OpenSourceSDRLab/RFSoC-27DR/images/RFSoC-27DR-angle-2.jpg

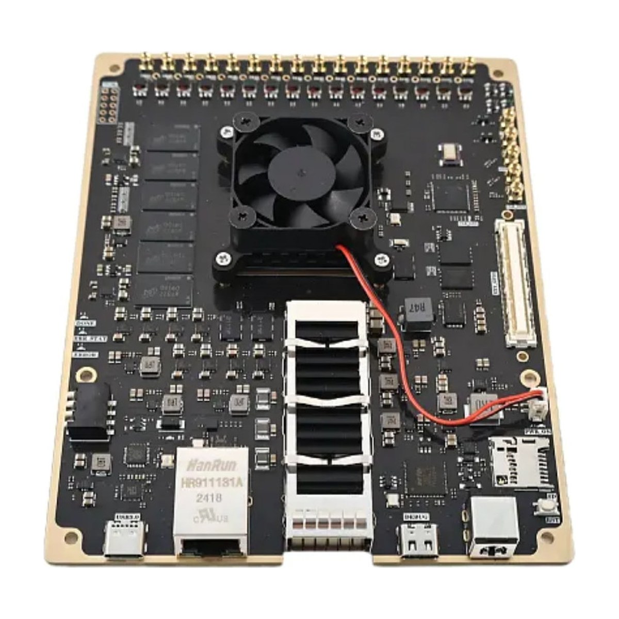
images/RFSoC-27DR-angle-2.jpg
