OpenSourceSDRLab/RFSoC-27DR/images/RFSoC-27DR-angle-3.jpg

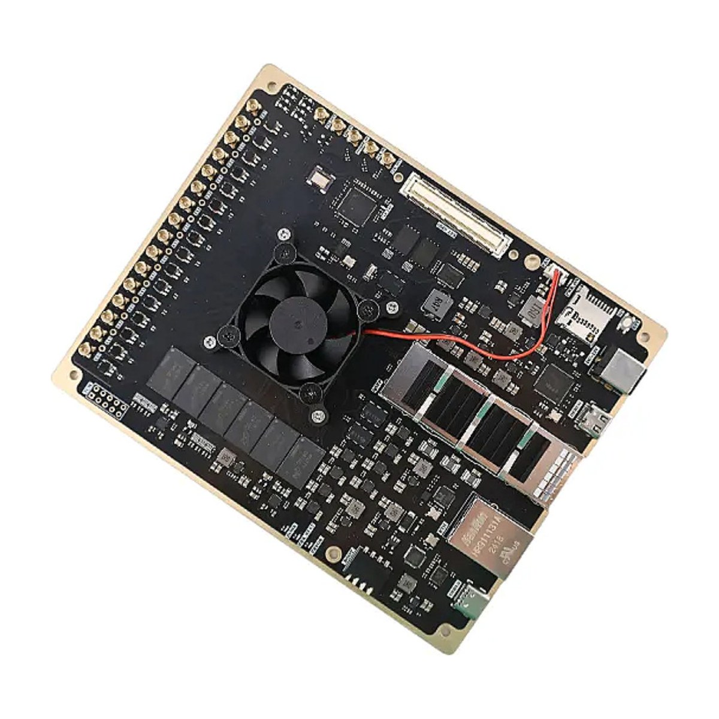
images/RFSoC-27DR-angle-3.jpg
