OpenSourceSDRLab/RFSoC-27DR/hardware/RFSoC-27DR_Schematic.pdf

## © 2026 OpenSourceSDRLab. All rights reserved. · www.opensourcesdrlab.com

# OPENSOURCESDRLAB DOCUMENTATION

# RFSoC-27DR Schematic

Product | RFSoC-27DR
Document | OSSDRLAB-RFSoC-27DR-SCH
Version | 1.0
Date | 2026-11-12

# This document contains the main schematic sheets of the OpenSourceSDRLab RFSoC-27DR board

(XCZU27DR RFSoC, 8T8R), exported from Altium Designer. It is a partial schematic: the power-supply (PMU) sheet is not included, and sheets 10 and 18 are blank in this edition. Some sheets carry short Chinese labels for function blocks; their meaning is given in the table. The schematic sheets follow this cover page.

OpenSourceSDRLab | RFSoC-27DR Schematic

## © 2026 OpenSourceSDRLab. All rights reserved. · www.opensourcesdrlab.com

Sheet | Content
1 | RFSoC PS configuration: system monitor, JTAG, boot mode, PS reference clock (33.3 MHz), PS MIO assignment (QSPI, SD, USB, Ethernet, UART, I2C, LMK04828 control)
2 | RFSoC PL I/O banks 88 and 89: LMK04828 SYNC, LEDs, PL clocks and SYSREF, expansion-connector I/O
3 | RFSoC I/O bank supply connections (VCCO)
4 | PS DDR4: four MT40A256M16GE devices, 64-bit
5 | PL DDR4: two MT40A256M16GE devices, 32-bit, banks 65/66
6 | PS-GTR transceivers (bank 505) and reference clocks
7 | GTY transceivers (quads 128 and 129) and reference clocks
8 | RF-ADC tiles 224–227 and RF-DAC tiles 228–229 with TC1-1-13MX+ baluns, converter reference clocks and SYSREF
9 | 12 V DC input and reverse-polarity protection (label: "DC power input")
10 | blank (power supply sheet not included)
11 | USB JTAG and UART: FT2232H, Type-C connector, EEPROM
12 | Gigabit Ethernet: RTL8211F PHY and RJ45
13 | USB 3.0: USB3320C ULPI PHY, Type-C connector and switch, VBUS power switch
14 | QSFP28 cage on GTY quad 128
15 | Clocking: LMK04828 clock generator, 19.2 MHz VCTCXO, 100 MHz and 156.25 MHz oscillators
16 | Other peripherals: reset supervisor ("reset control"), boot-mode switch ("boot mode": JTAG/QSPI/eMMC/SD), dual QSPI flash, I2C EEPROM, microSD slot ("TF card"), status and user LEDs ("indicator LEDs"), fan header ("fan")
17 | Expansion interface: FX10A-120S-SV 120-pin connector and MMCX clock / SYSREF / trigger connectors
18 | blank

Product page: https://opensourcesdrlab.com/products/opensourcesdrlab-rfsoc-development-board-equipped-with-usb-30-socket (https://opensourcesdrlab.com/products/opensourcesdrlab-rfsoc-development-board-equipped-with-usb-30-socket)

# Questions about the hardware: support@opensourcesdrlab.com

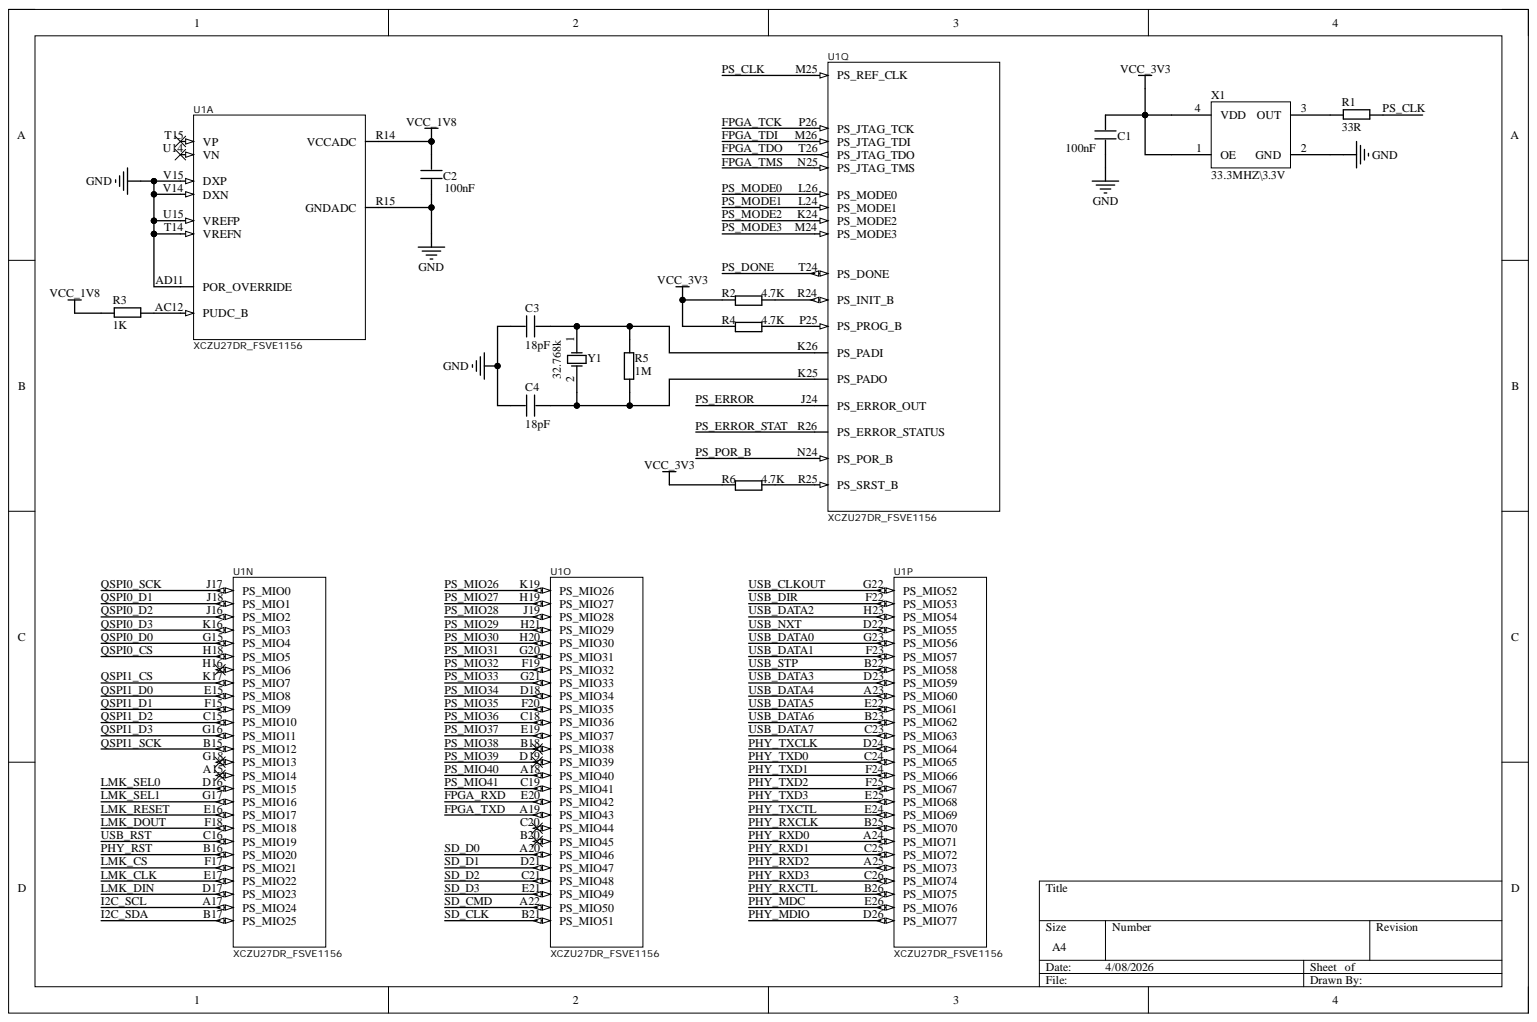
[picture p8: page 3]

### COU1D

### COU1E

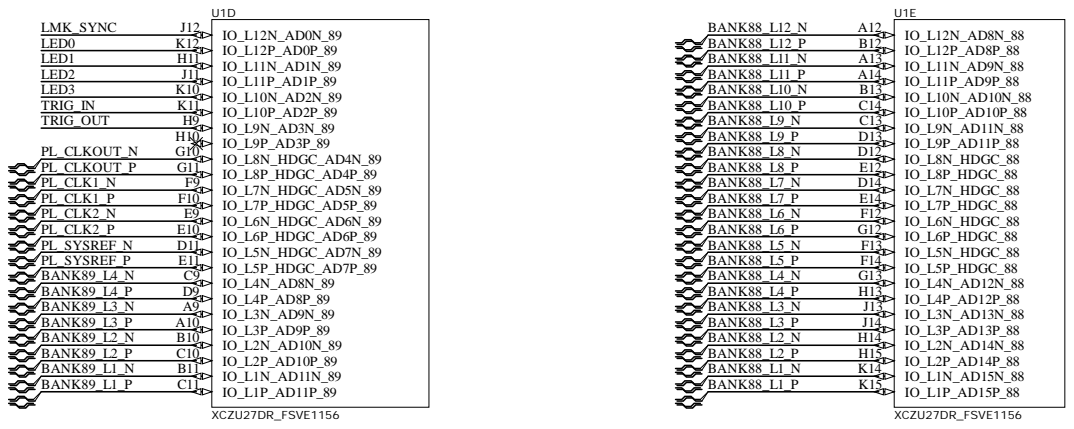
[picture p9: page 4]

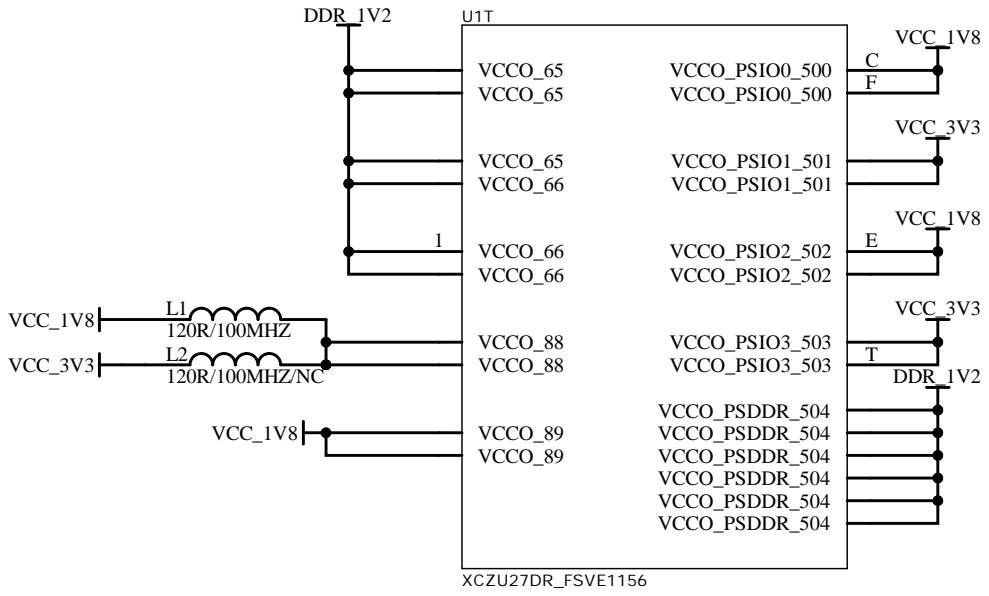
[picture p10: page 5]
VCC_3V3; VCC_1V8; 120R/100MHZ/NC; 120R/100MHZ; DDR_1V2; XCZU27DR_FSVE1156; VCCO_PSDDR_504; T VCCO_PSIO3_503; VCCO_PSIO3_503; VCCO_PSIO2_502; E VCCO_PSIO2_502; VCCO_PSIO1_501; F VCCO_PSIO0_500; C VCCO_PSIO0_500; VCCO_89; VCCO_88; VCCO_66; VCCO_65; File:; Date:; Sheet of; Size; Number; Revision; Title; PIL101; PIL102 COL1; PIL201; PIL202 COL2; PIU10AE12; PIU10AF15; PIU10AF25; PIU10AG28; PIU10AH11; PIU10AJ14; PIU10AK17; PIU10AK27; PIU10AL10; PIU10AL30 PIU10AN26; PIU10AP29; PIU10C17; PIU10D10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

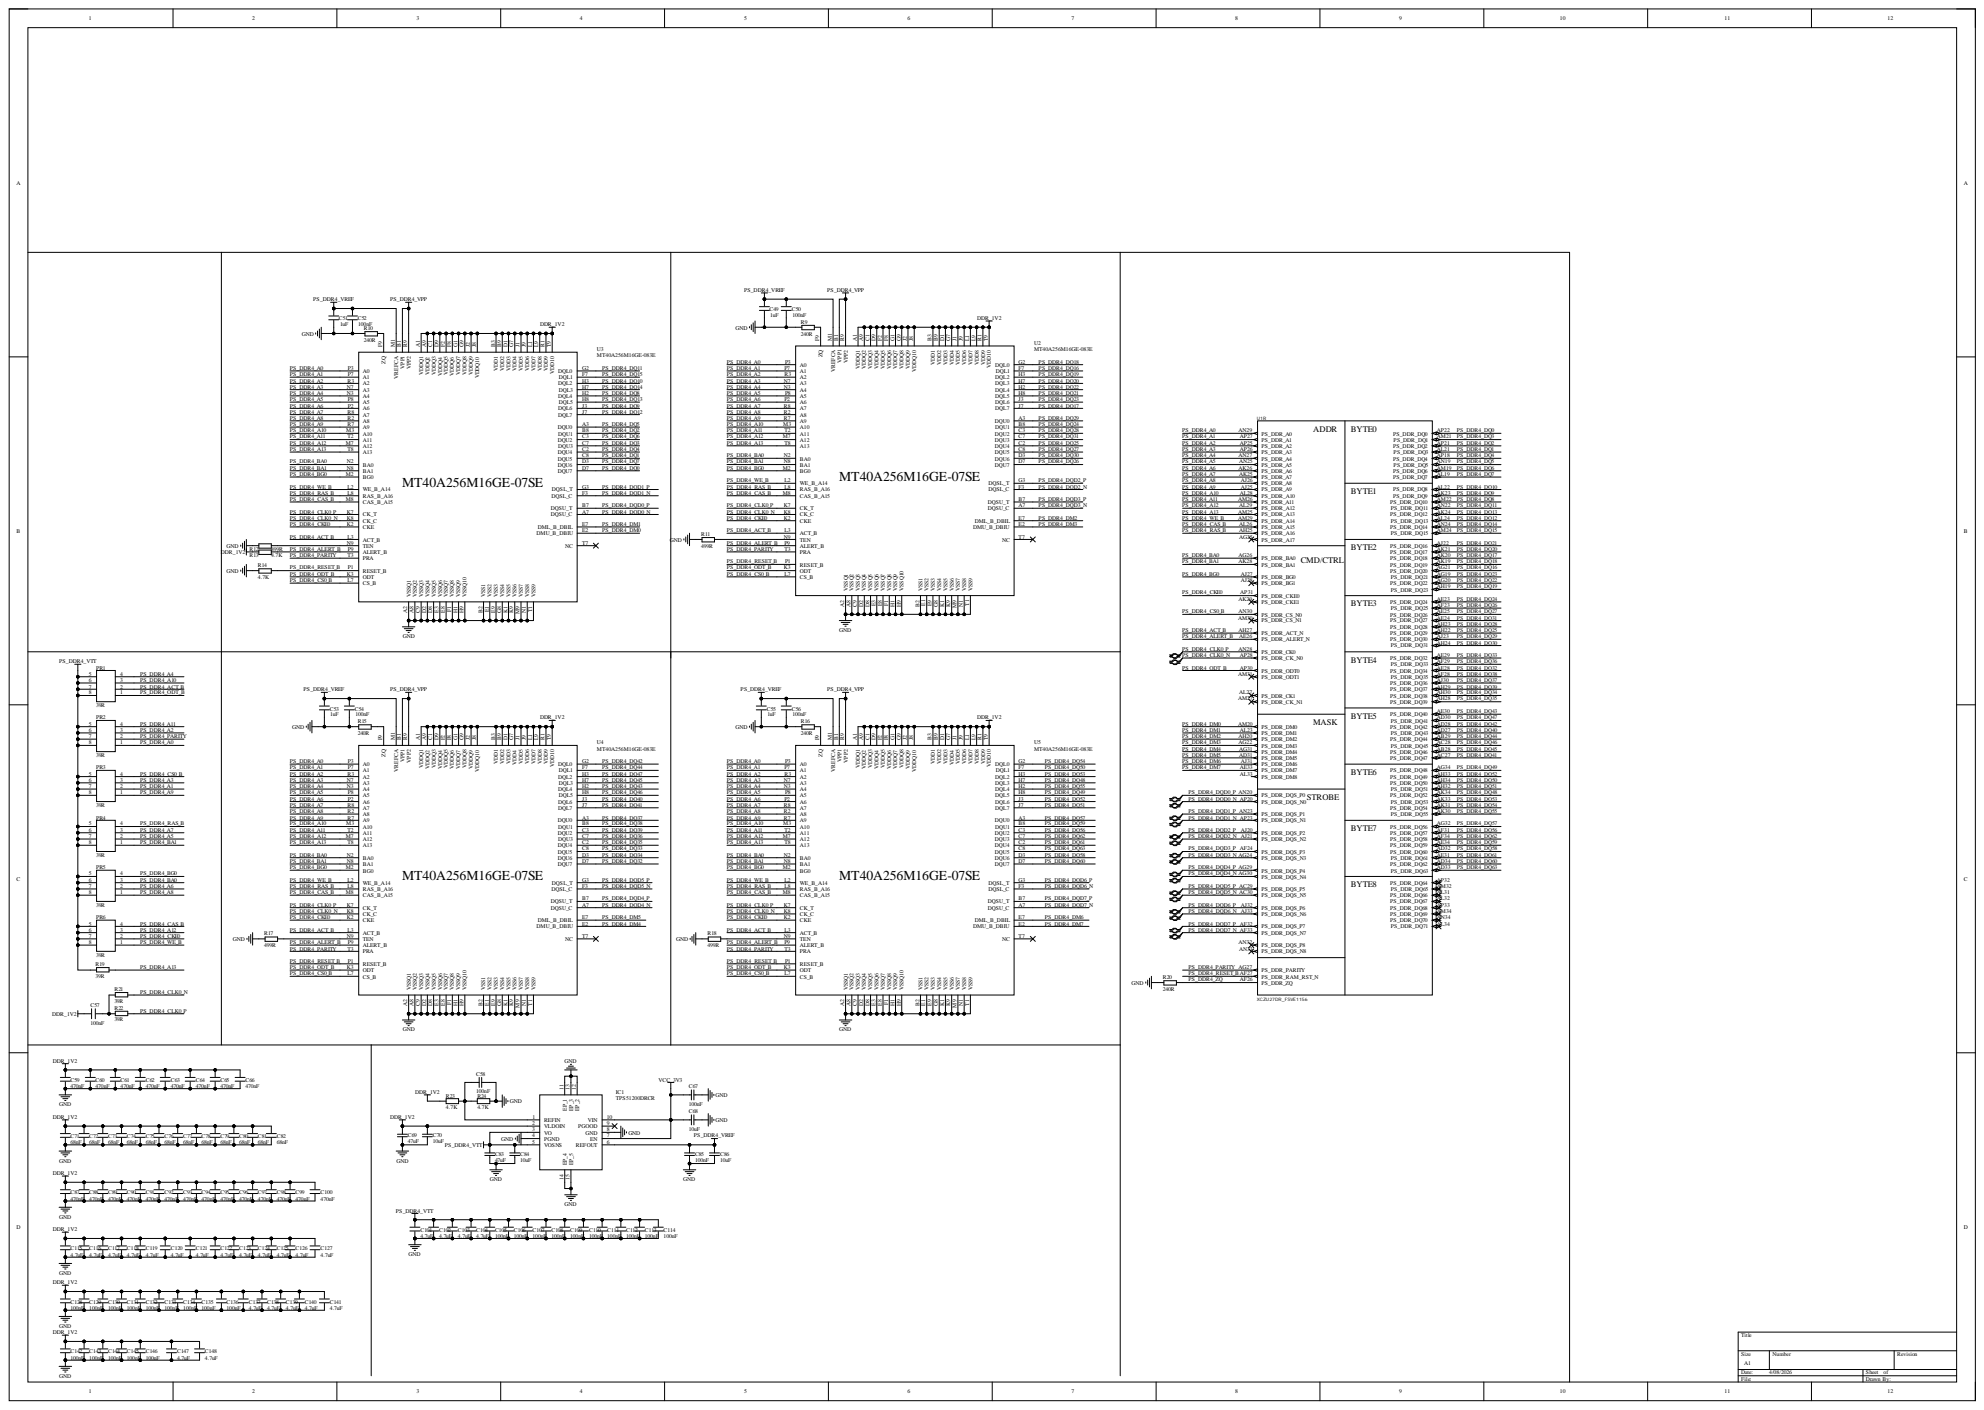
[picture p11: page 6]

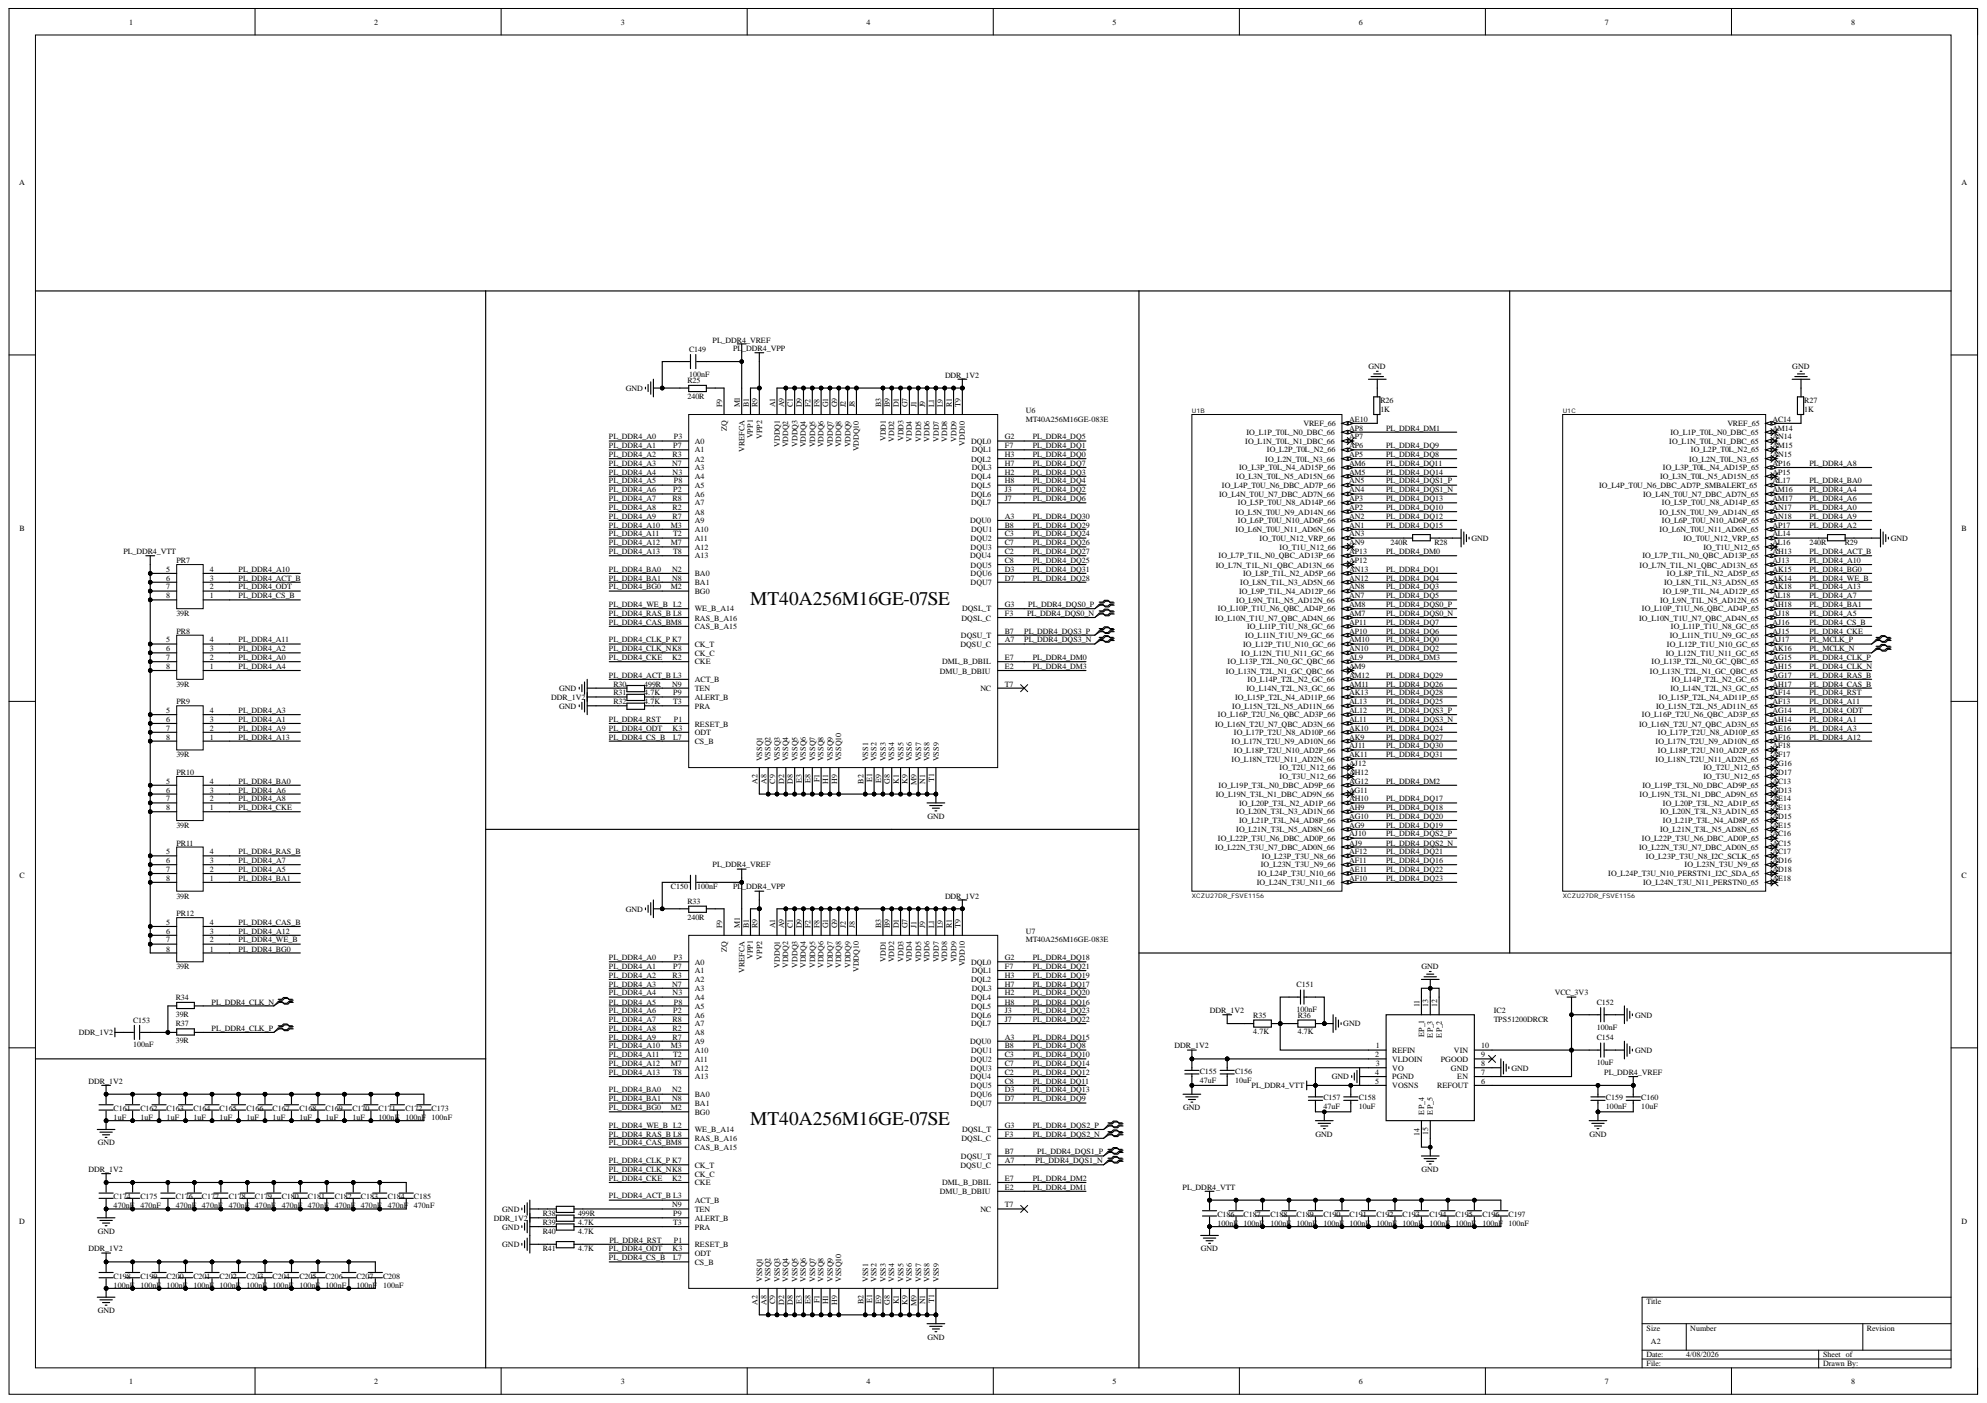
[picture p12: page 7]

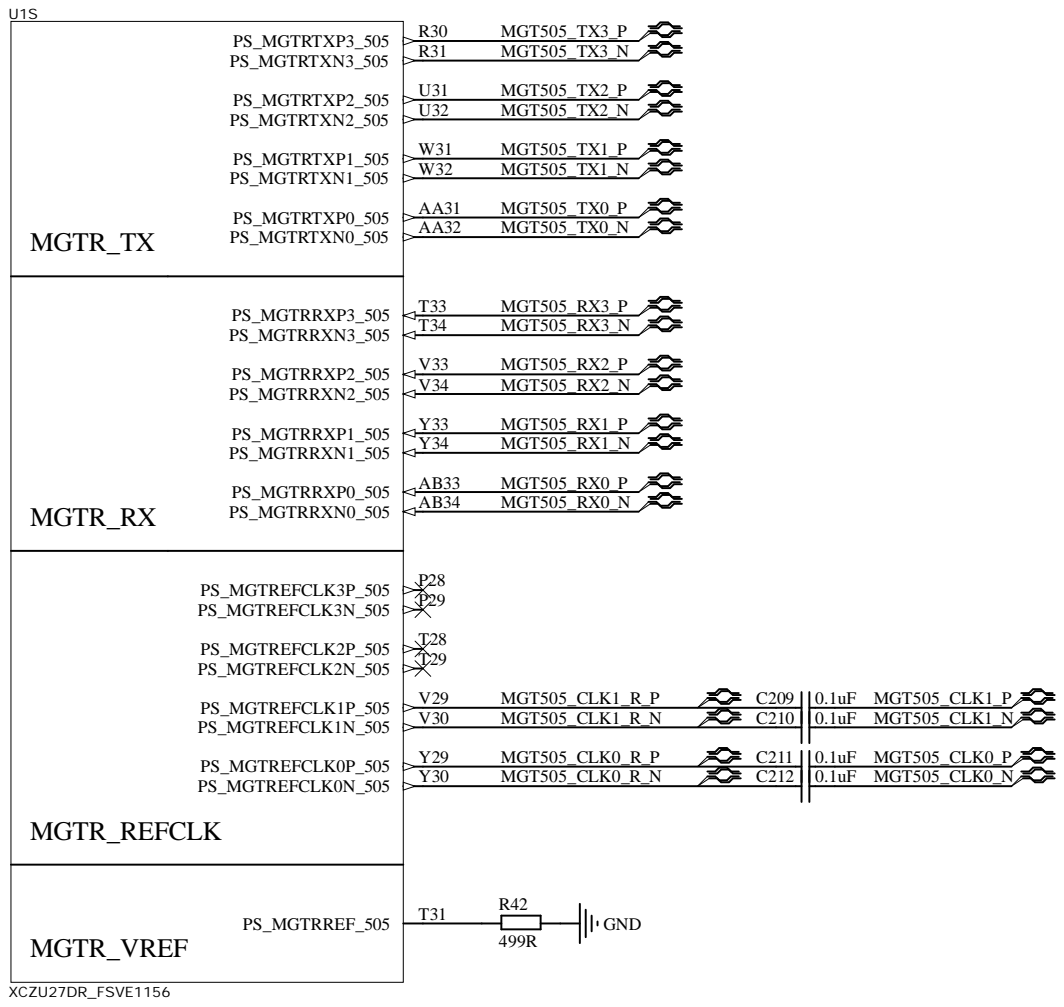
[picture p13: page 8]

M

## GTY_

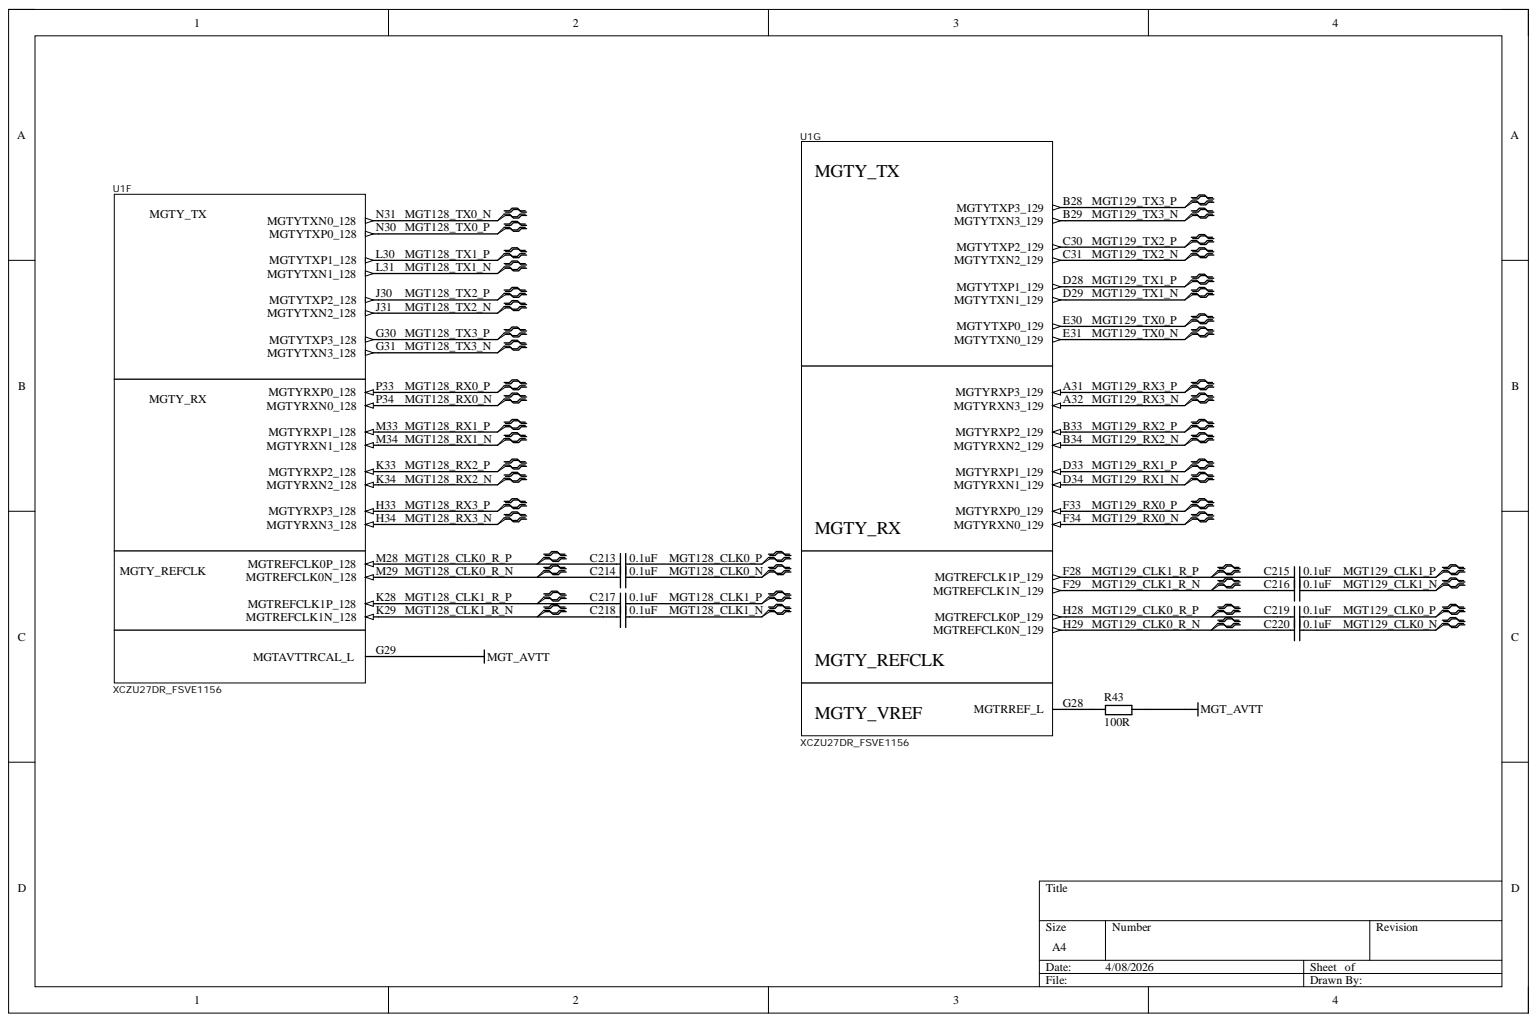
[picture p14: page 9]
Size; umb; Rev; Dat; Sheet; TREFCL; 9 MGTREFCLK0P_129; 9 MGTREFCLK1P_129; TRREF_; YRX; YRXP0; YRXP1; YRXP2; YRXP3; GTY_; GTY_REFC; GTY_VR; XCZU27DR_FSVE1156; 9 MGTREFCLK0P_128; 9 MGTREFCLK1P_128; TAV; TRCA; _REFCL; Drawn By:

# U1I XCZU27D

# U1H XCZU27D

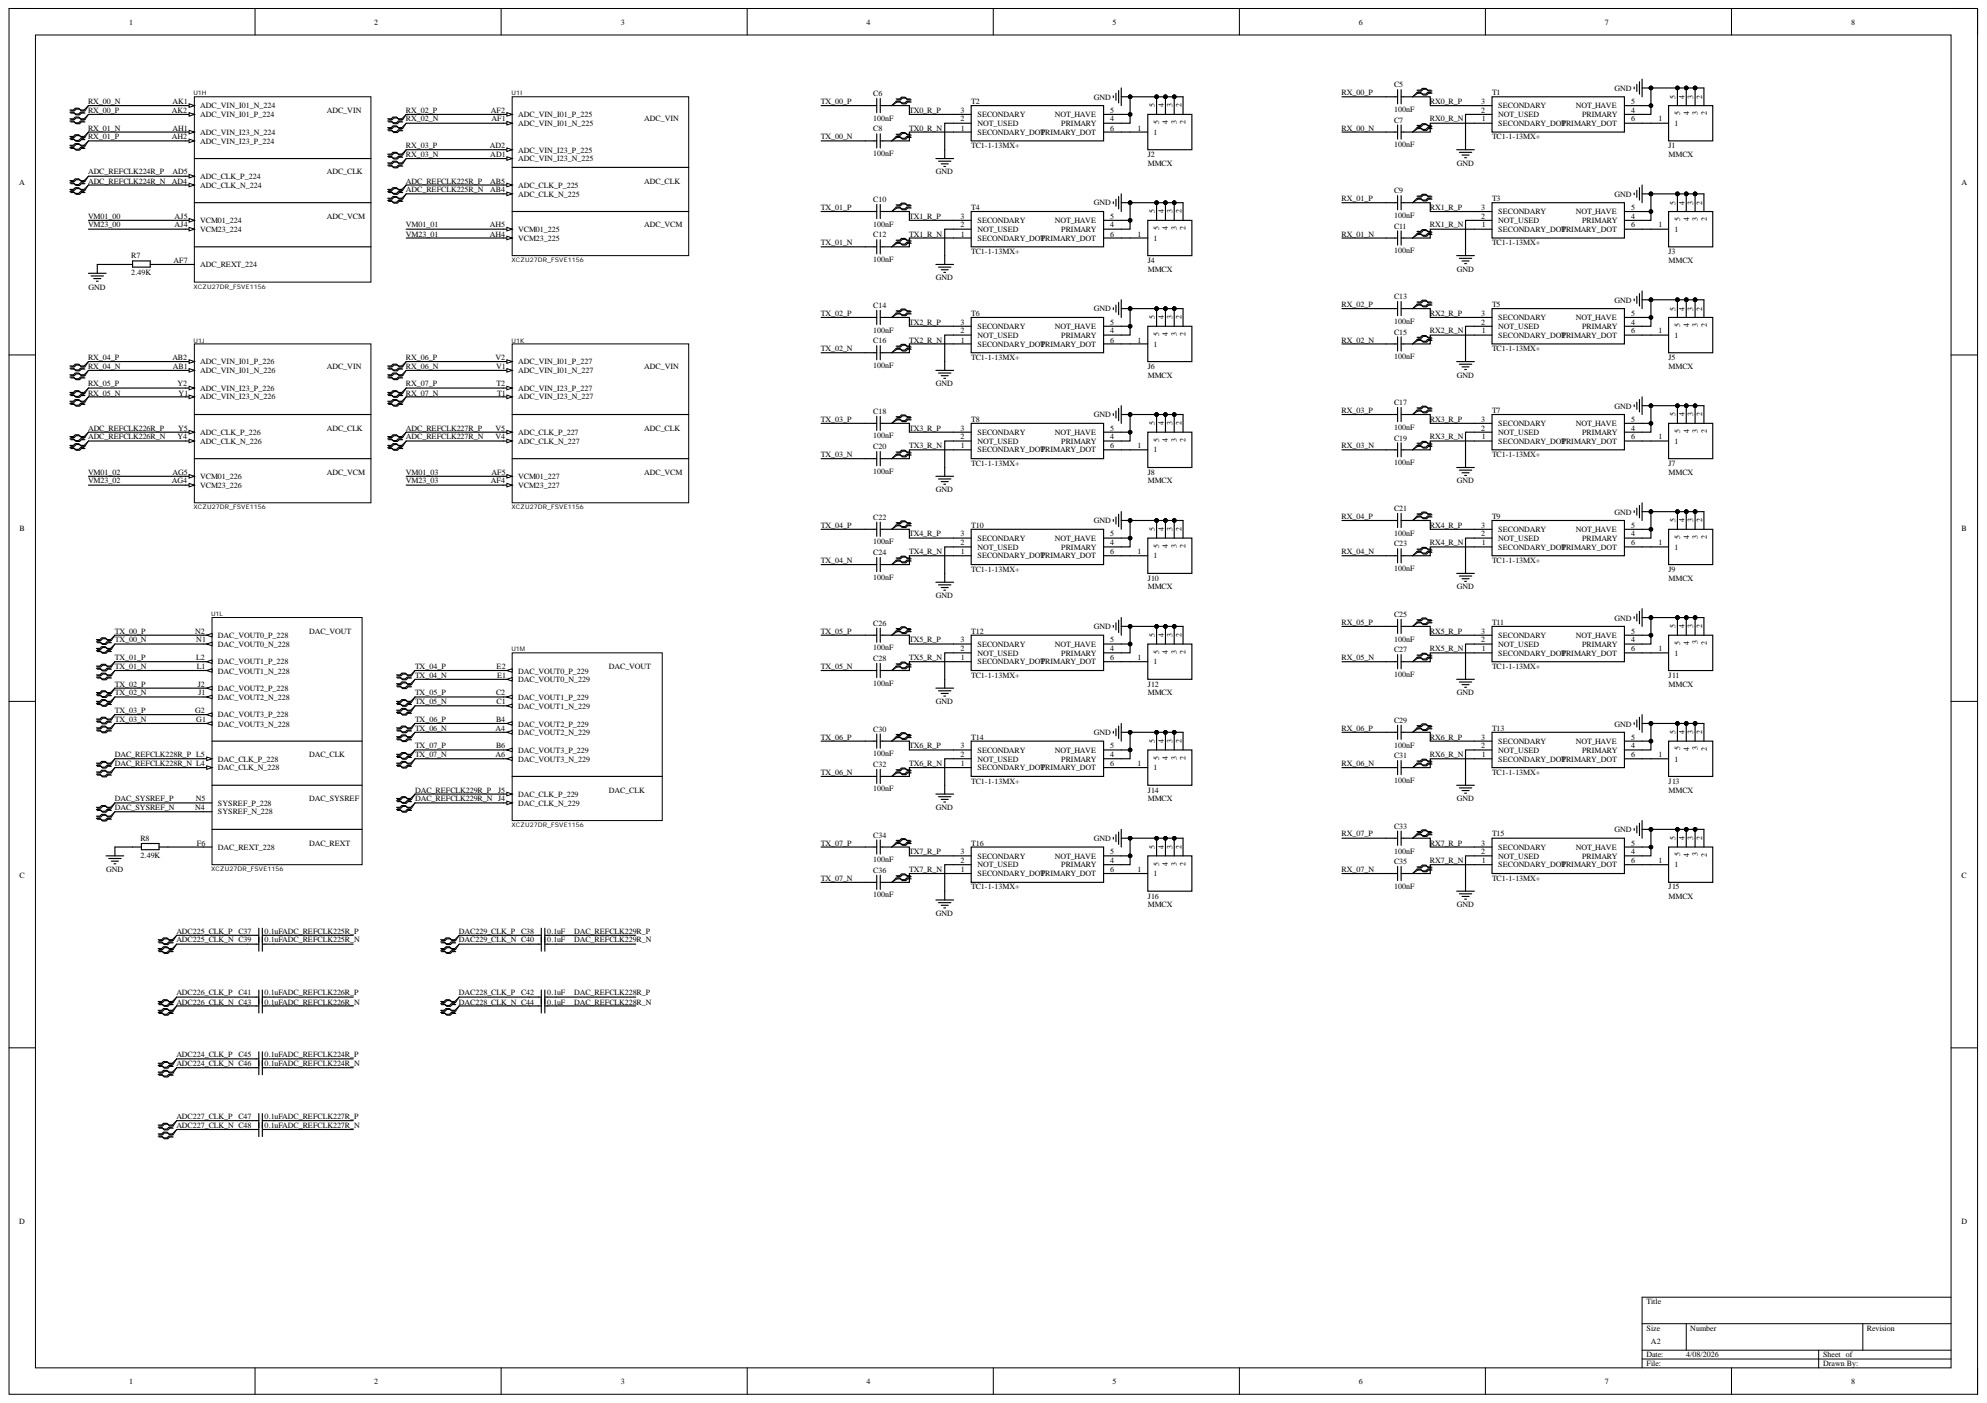
[picture p15: page 10]

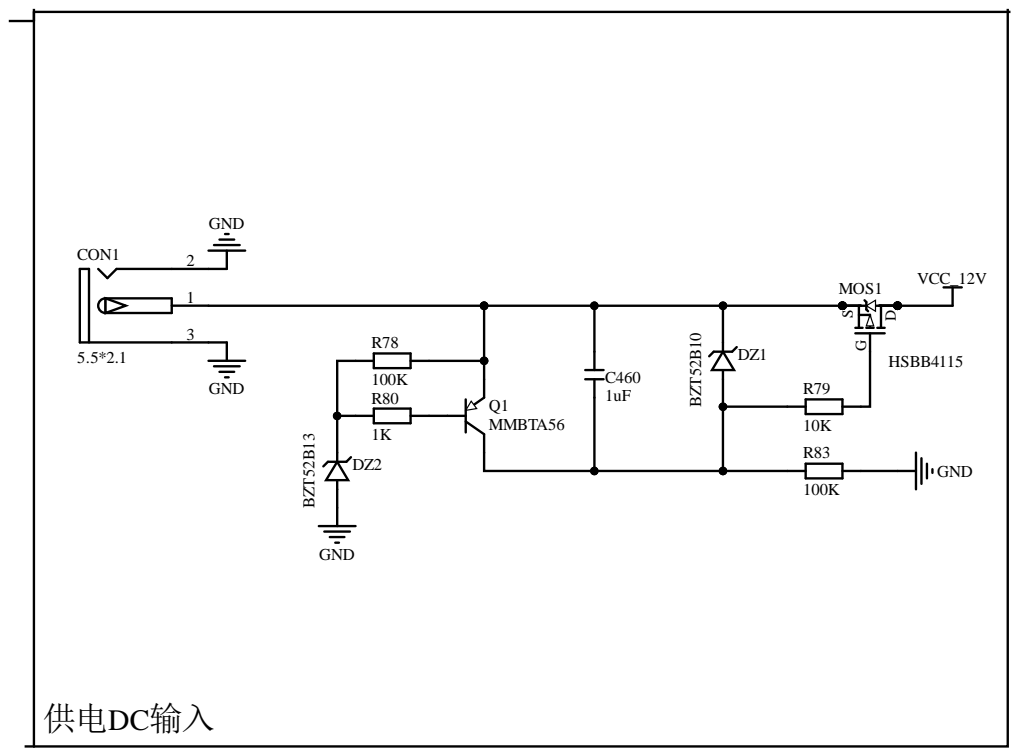
[picture p16: page 11]
CON1; GND; 电DC; BZT52B10; BZT52B13; MOS

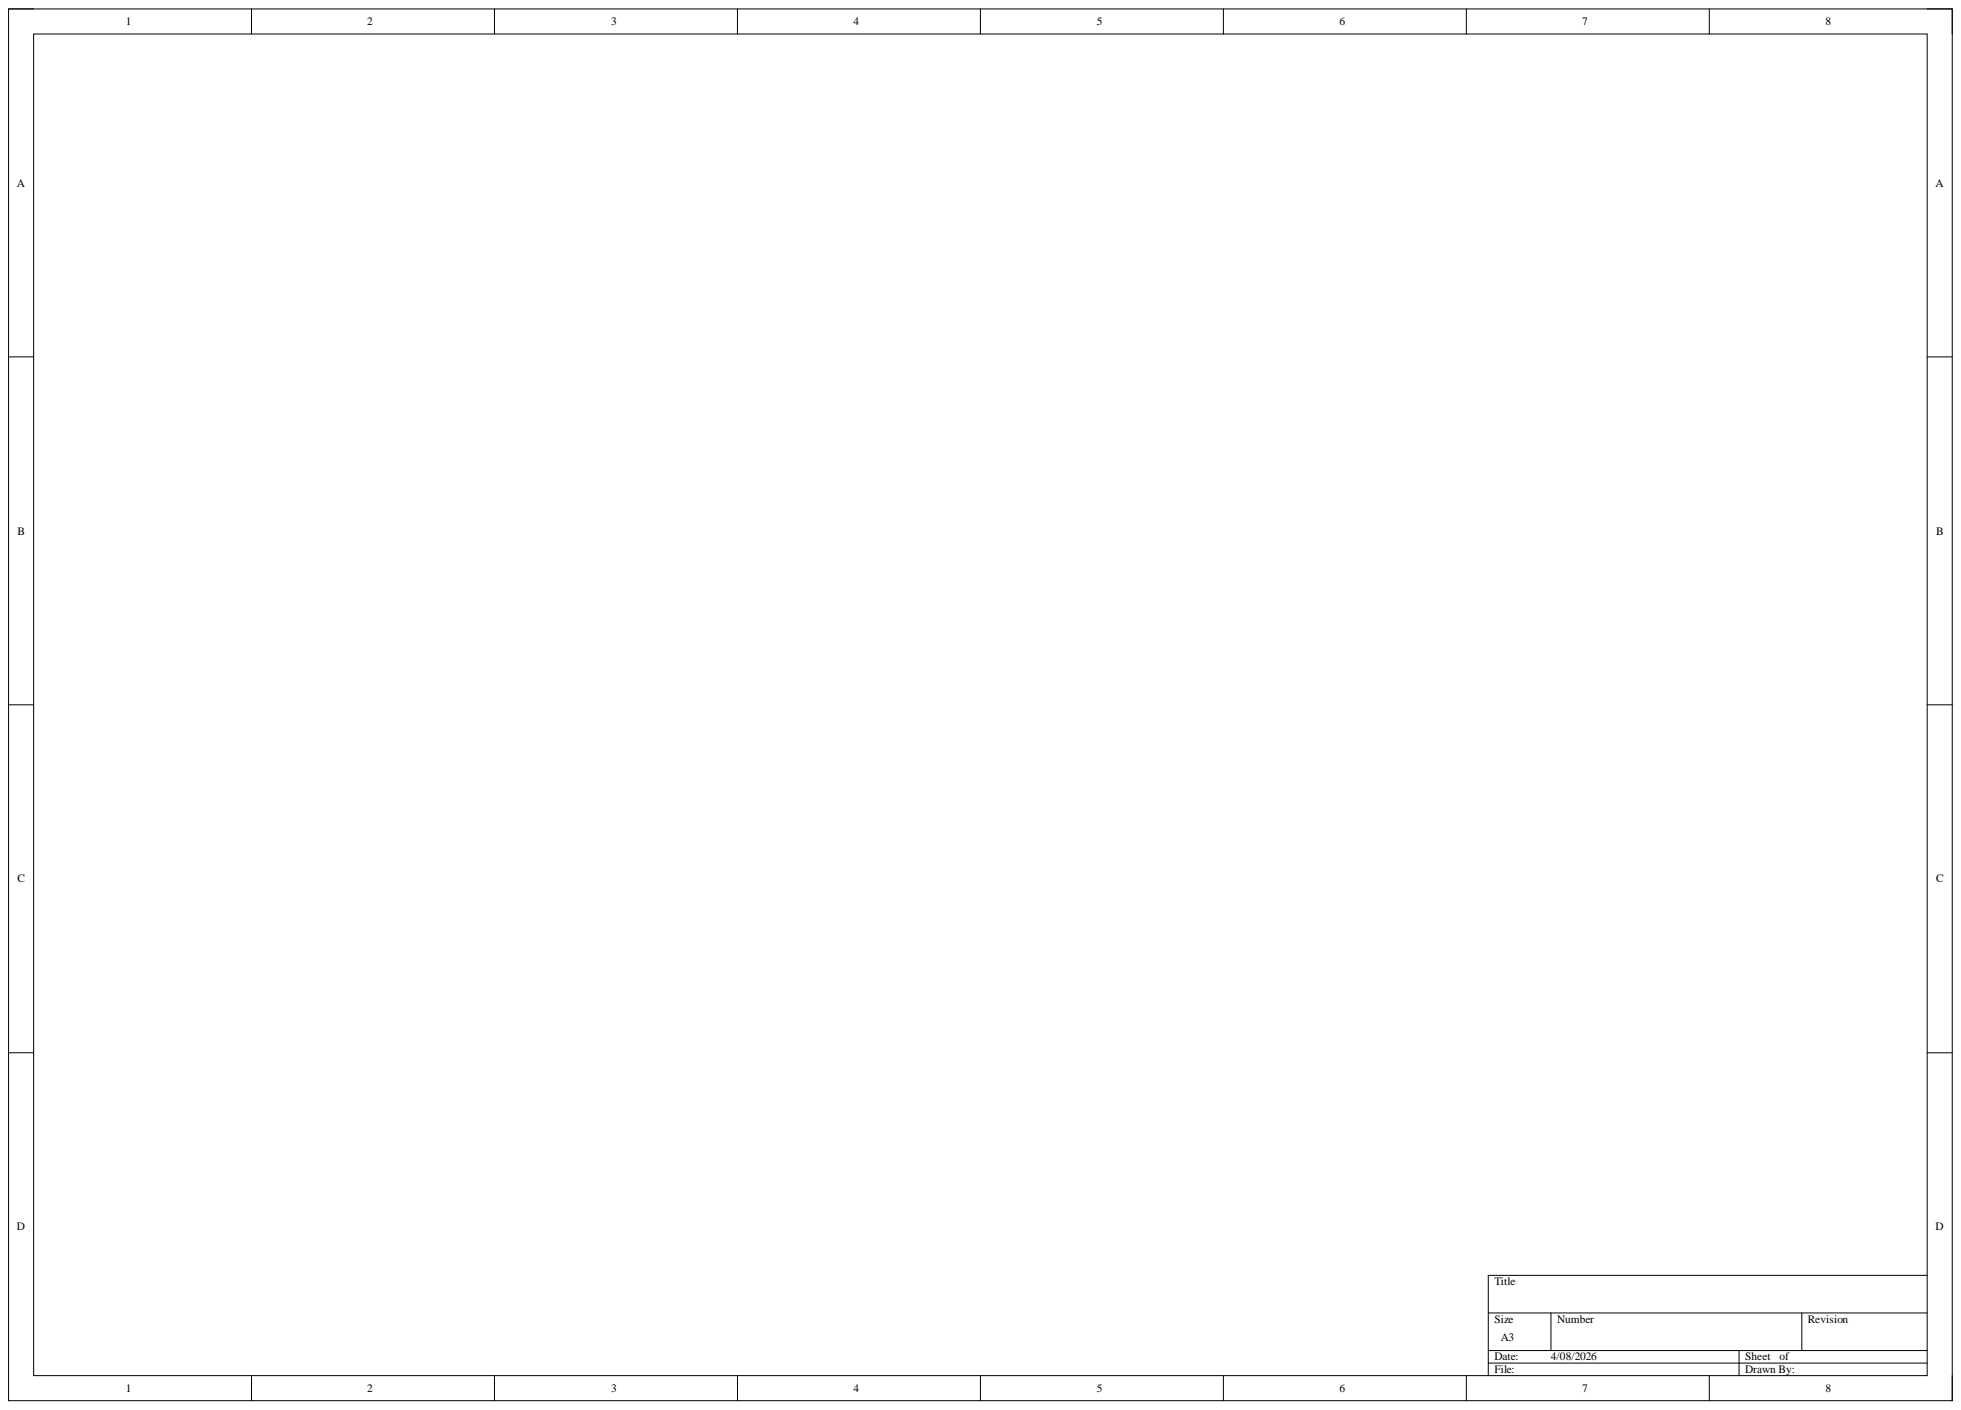
[picture p17: page 12]
Title; Size; Number; Revision; File:; Drawn By:

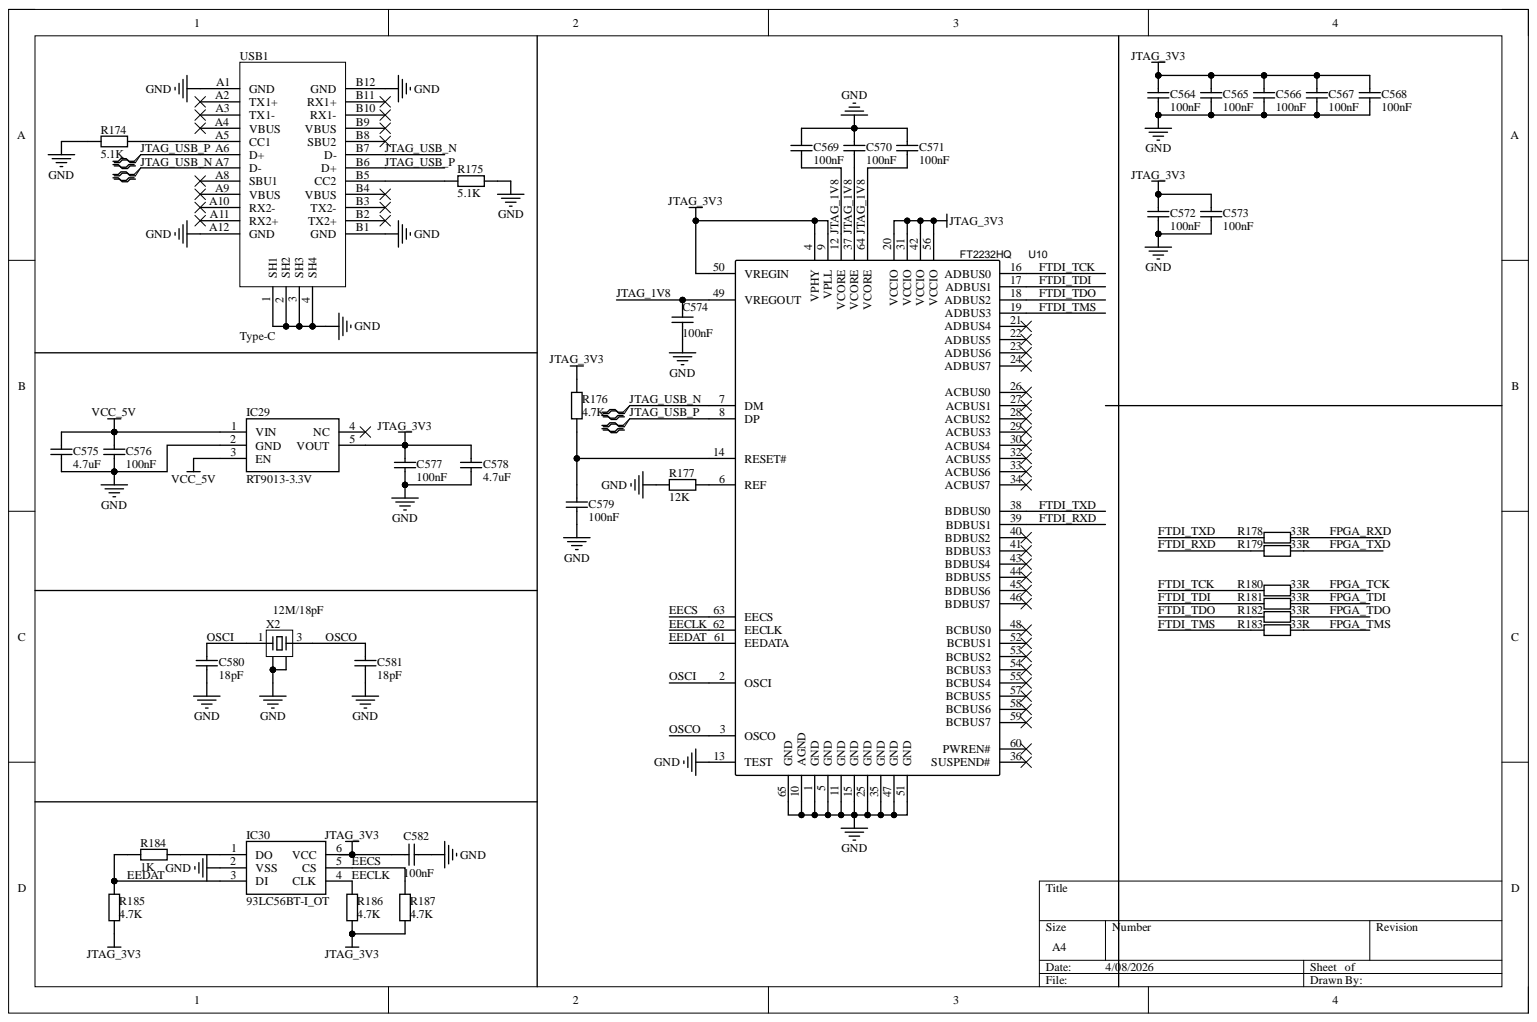
[picture p18: page 13]

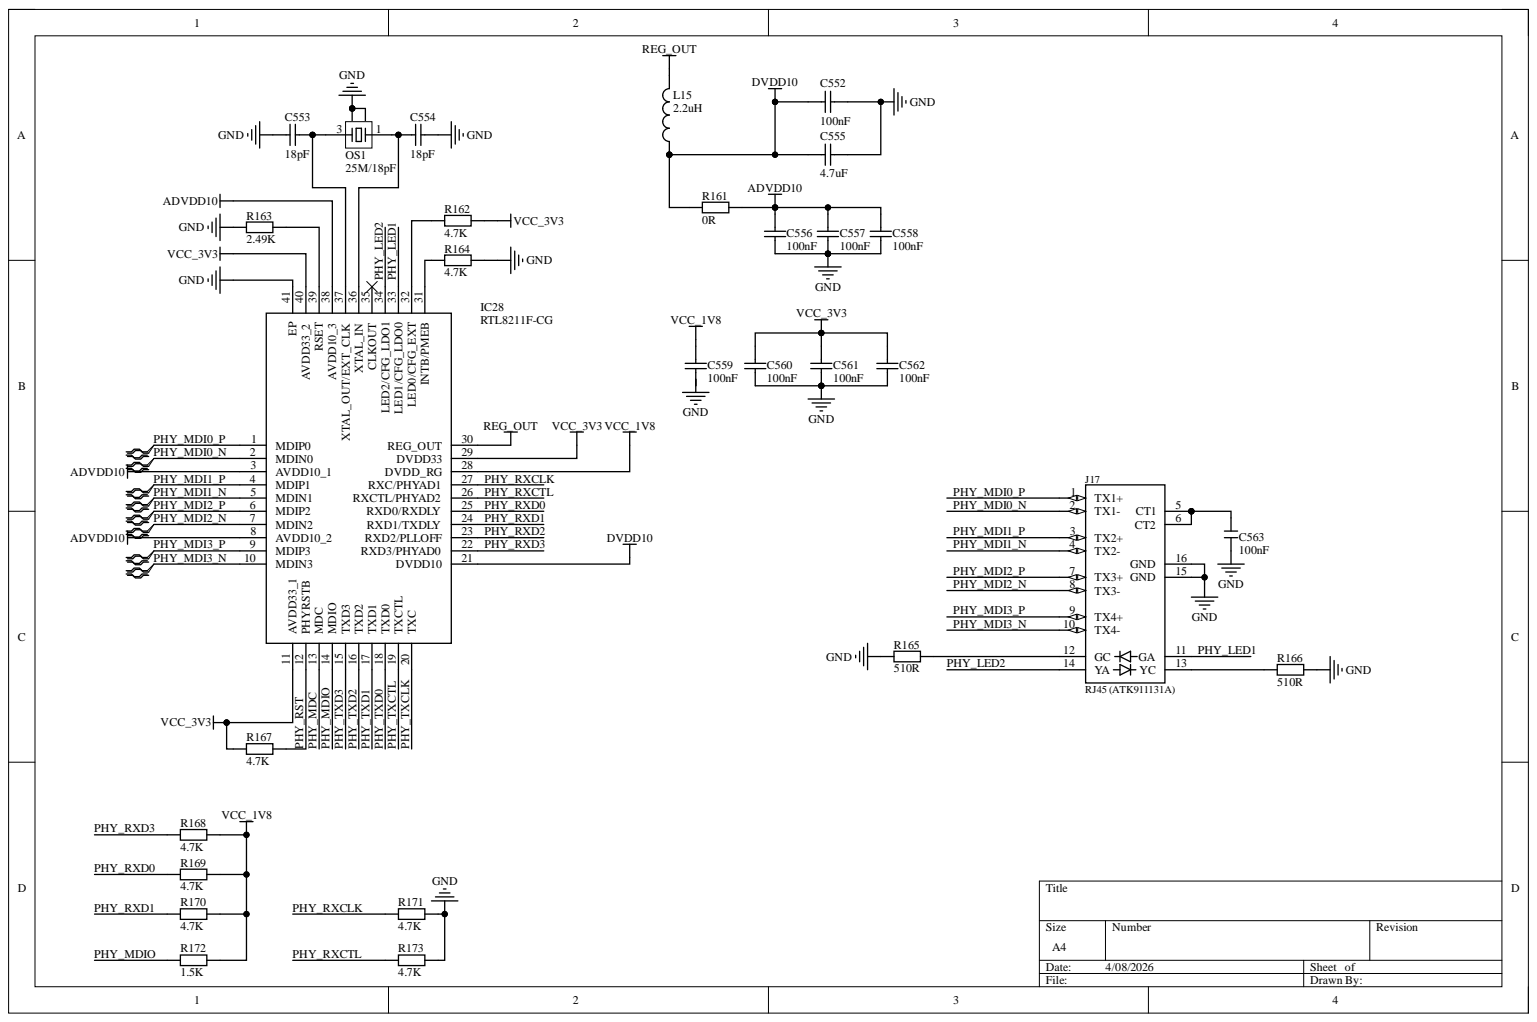
[picture p19: page 14]

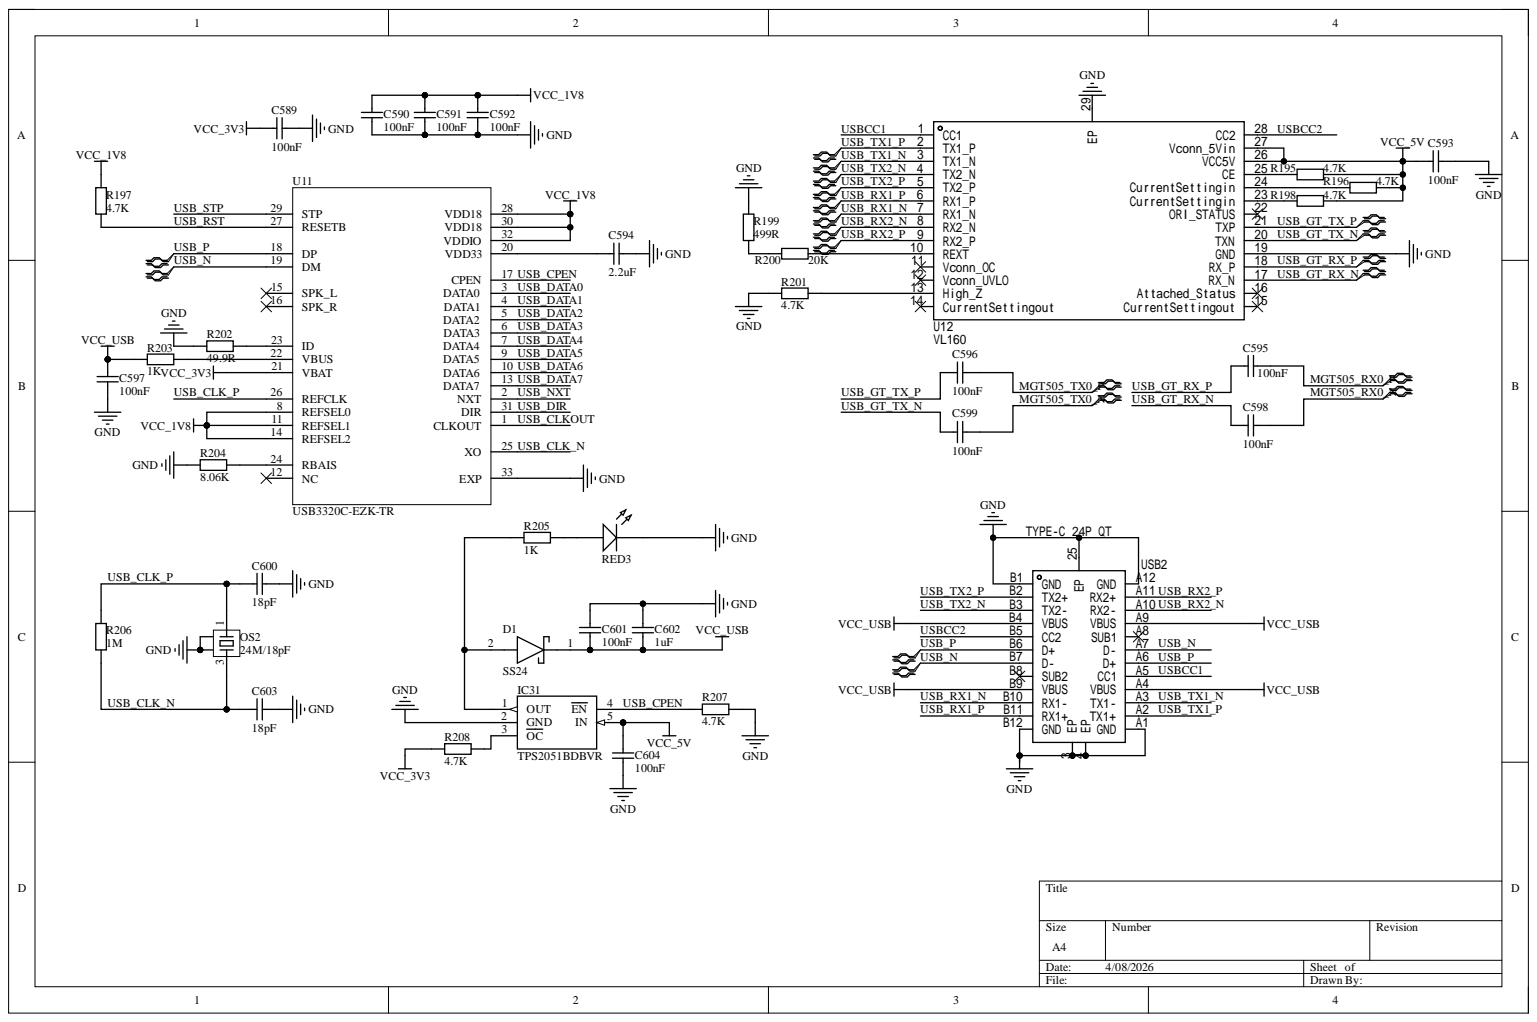
[picture p20: page 15]

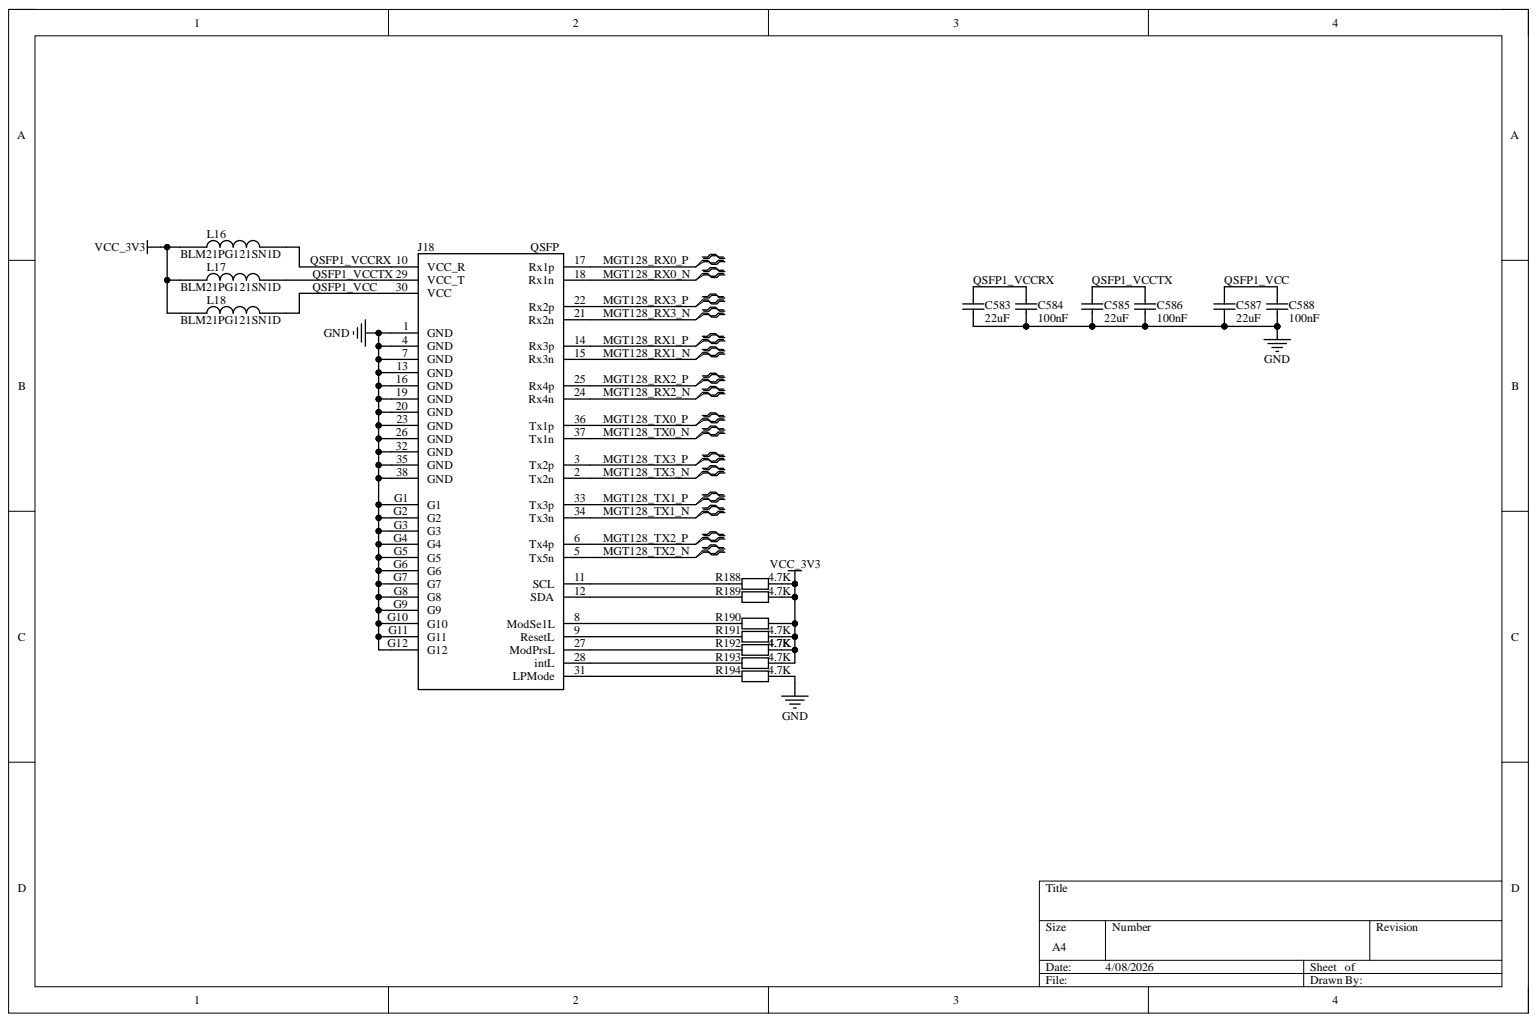
[picture p21: page 16]
Size; umb; Rev; Dat; Sheet; Draw; dSe1; Reset; VCC_; SCL; dPrs; VCC; LPMo; QSFP; BLM2; QSFP1; KGN

O 10 | LDOBYP1 11 | LDOBYP2 12
1 17 | CS 18

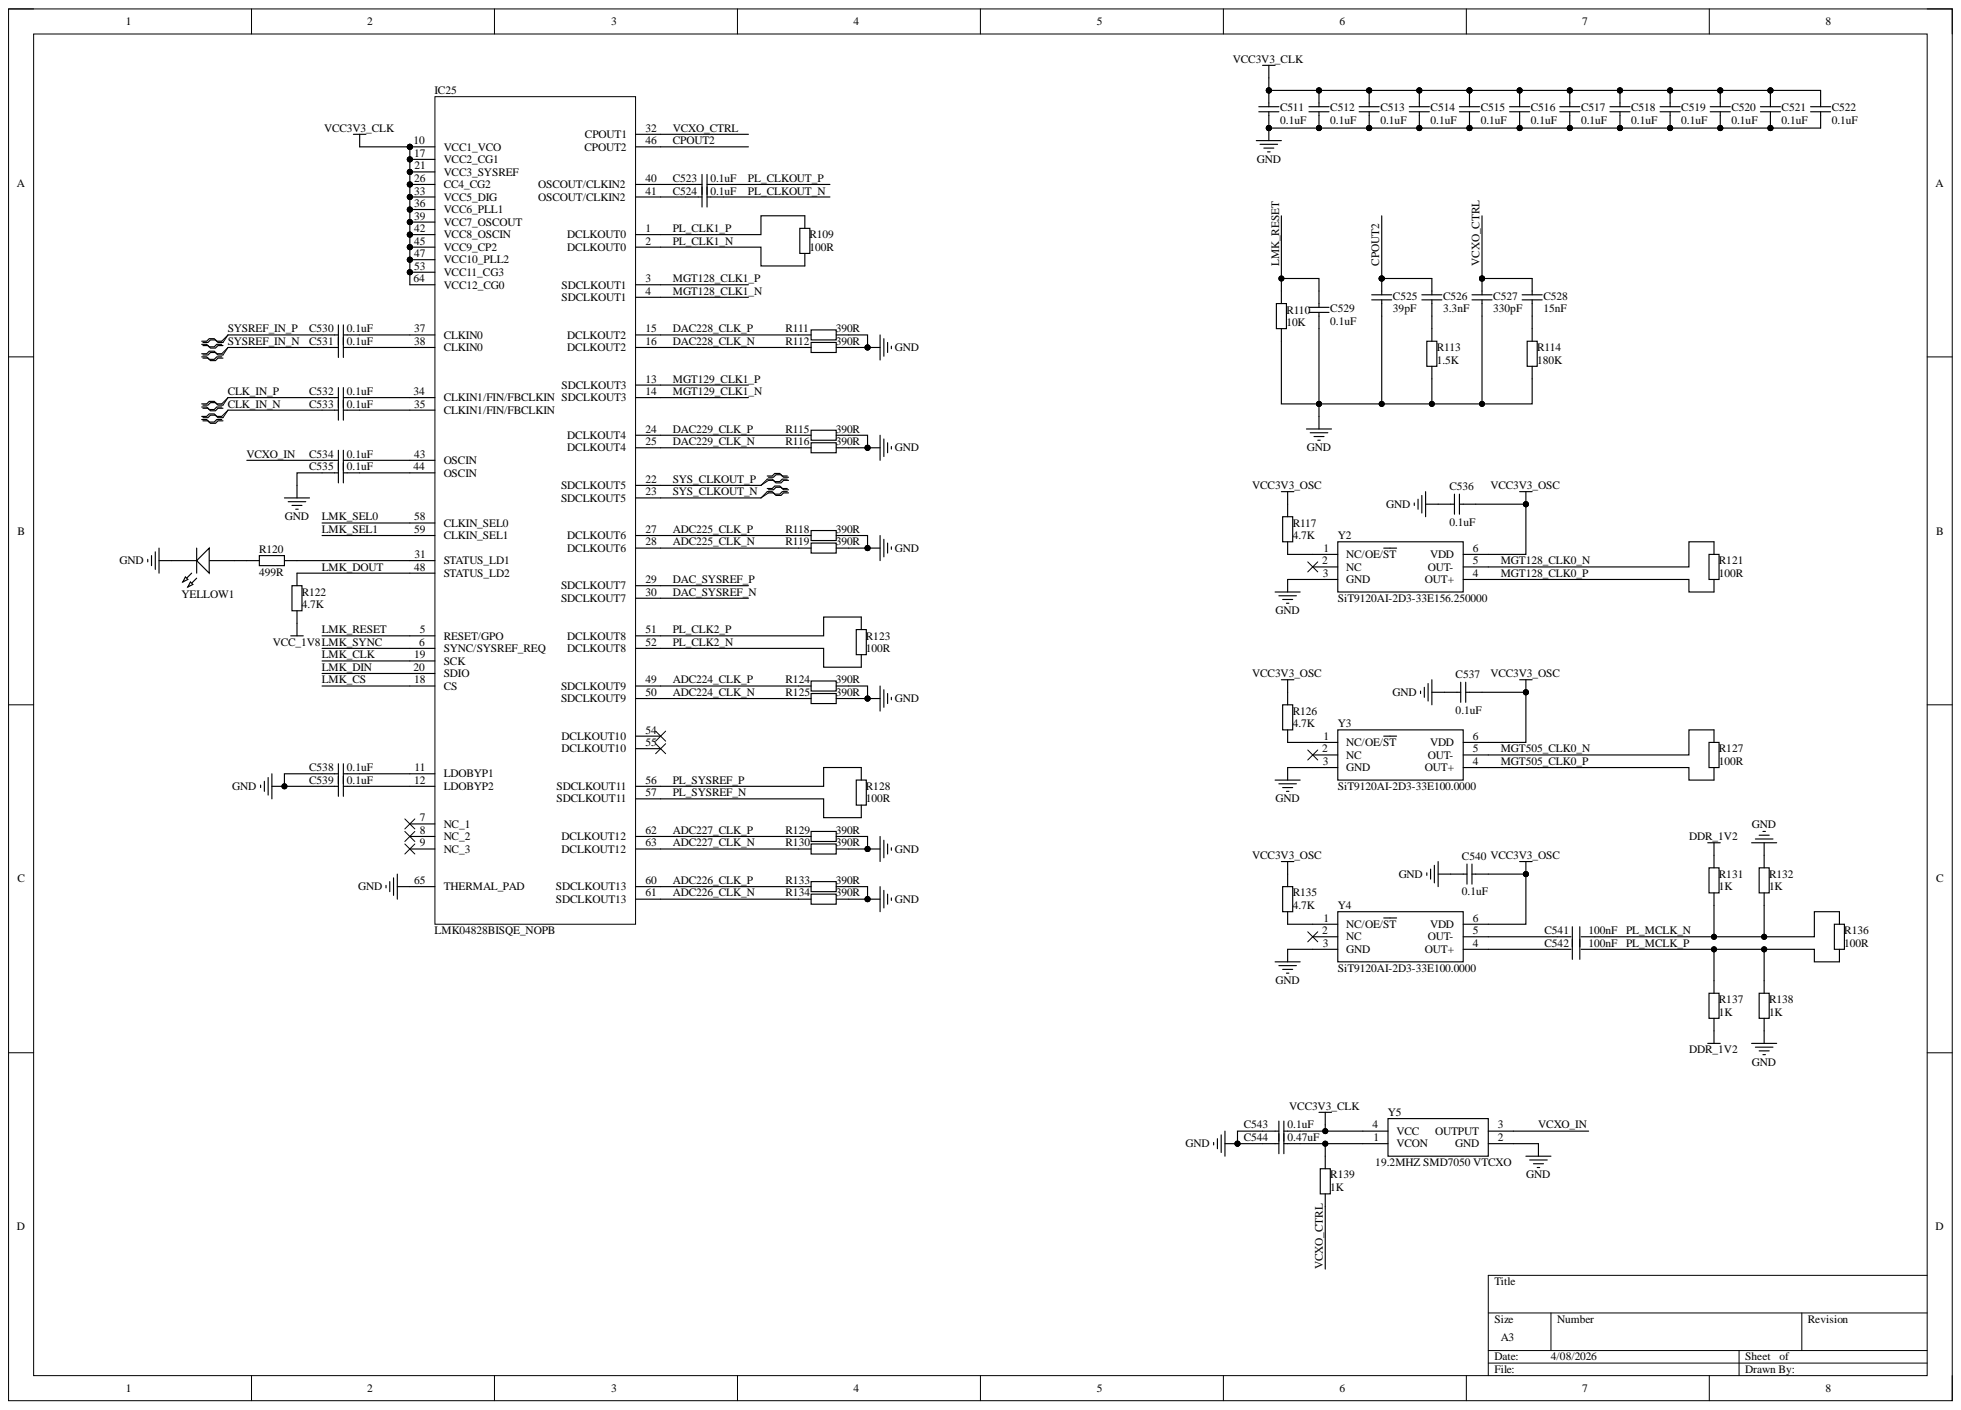
[picture p22: page 17]

# 复位控制

# 启动模式

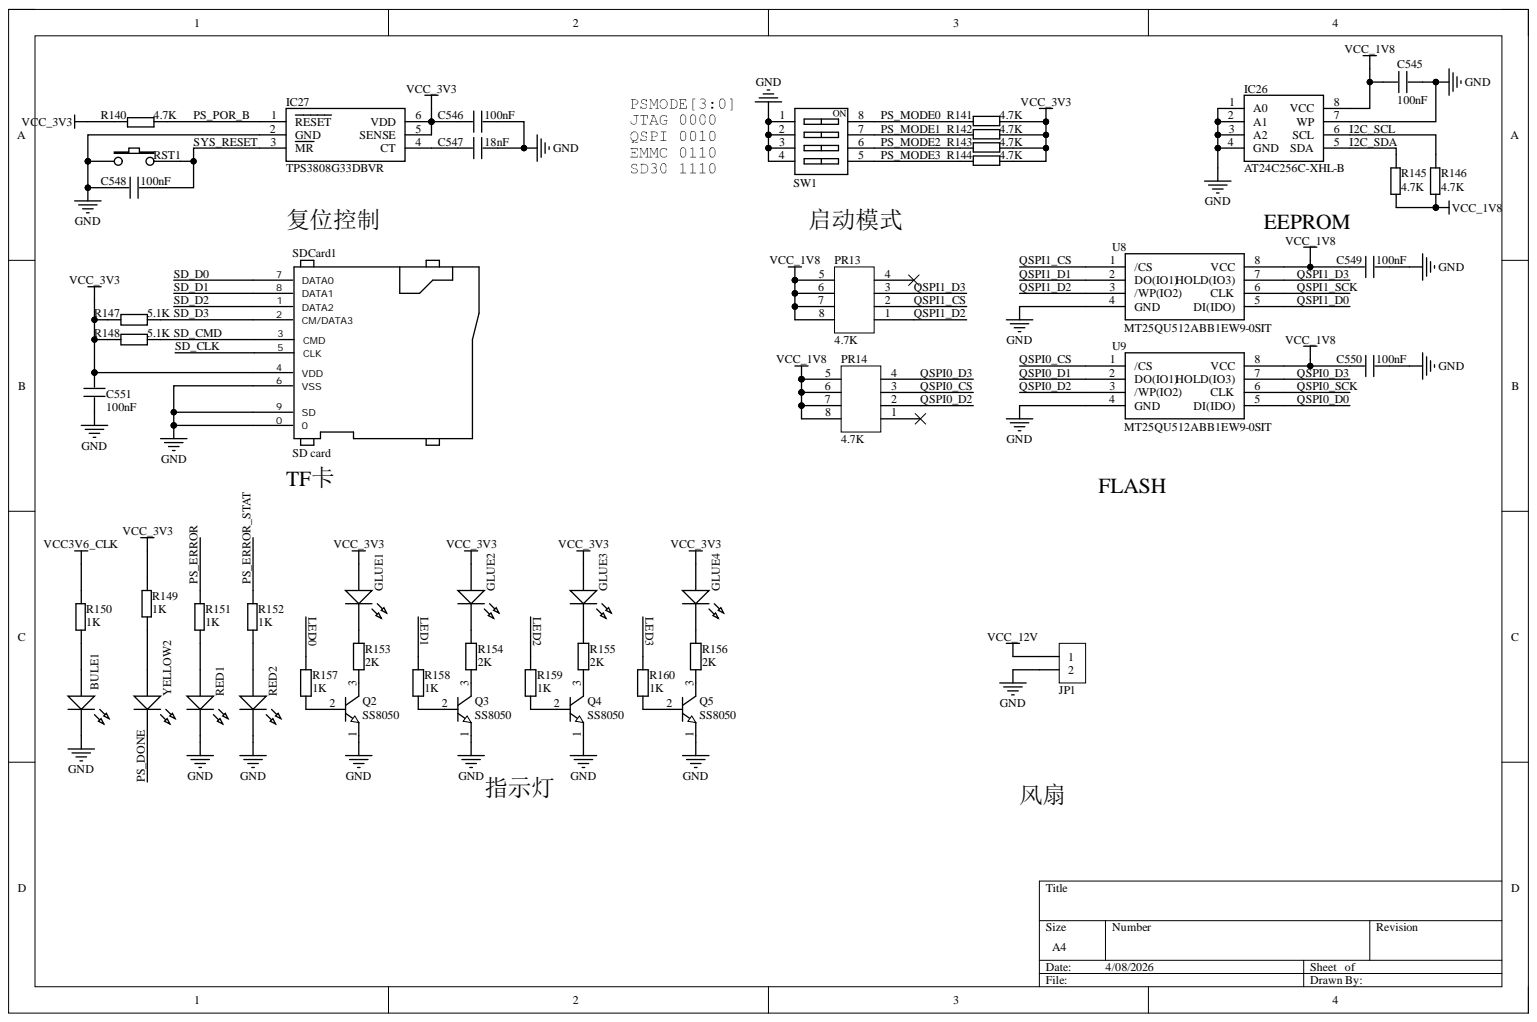
[picture p23: page 18]

# _NVCC_

# MMCX 1

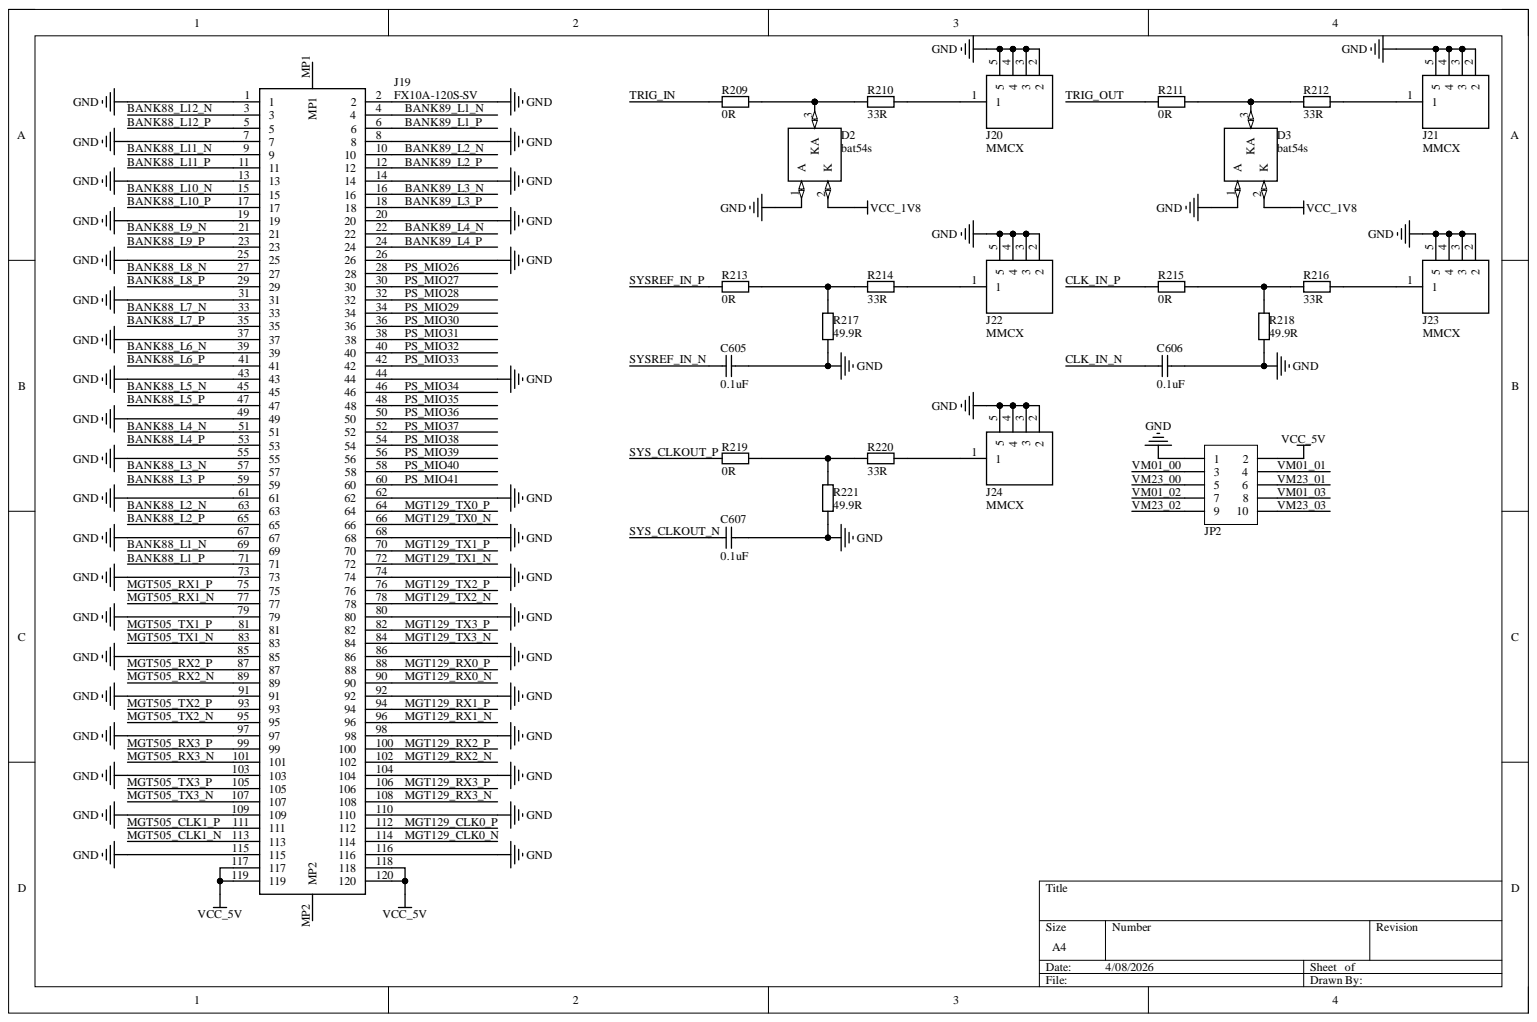
[picture p24: page 19]
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
