OpenSourceSDRLab/RFSoC-27DR/vivado/AD_DA_Loopback/AD_DA_LOOP_MTS_PS/AD_DA_LOOP_MTS/src/spi_ctrl.c

#include "spi_ctrl.h"
#include "platform_drivers.h"
#include "parameters.h"
#include <stdint.h>
#include <stdio.h>
#include <math.h>


uint32_t lmk04828_init_256 [] = {
		0x000090,
		0x000010,
		0x000200,
		0x000306,
		0x0004D0,
		0x00055B,
		0x000600,
		0x000C51,
		0x000D04,
		0x01000C,
		0x010155,
		0x010255,
		0x010300,
		0x010400,
		0x010500,
		0x010670,
		0x010711,
		0x01080C,
		0x010955,
		0x010A55,
		0x010B00,
		0x010C00,
		0x010D00,
		0x010E70,
		0x010F16,
		0x01100C,
		0x011155,
		0x011255,
		0x011300,
		0x011400,
		0x011500,
		0x011670,
		0x011716,
		0x01180C,
		0x011955,
		0x011A55,
		0x011B00,
		0x011C20,
		0x011D00,
		0x011E70,
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
};

int32_t spi_write32(spi_device *spi, uint32_t val) {
	uint8_t buf[4];
	int32_t ret;
	uint32_t cmd = val;

	buf[0] = cmd >> 24;
	buf[1] = cmd >> 16;
	buf[2] = cmd >> 8;
	buf[3] = cmd & 0xFF;

	ret = spi_write_and_read(spi, buf, 4);
	return ret;
}
int32_t spi_write24(spi_device *spi, uint32_t val) {
	uint8_t buf[3];
	int32_t ret;
	uint32_t cmd = val;

	buf[0] = cmd >> 16;
	buf[1] = cmd >> 8;
	buf[2] = cmd & 0xFF;

	ret = spi_write_and_read(spi, buf, 3);
	return ret;
}
int32_t lmk04828_init(spi_device *spi) {
	int ret;
	int i;

	for (i = 0; i < ARRAY_SIZE(lmk04828_init_256); i++) {
		ret = spi_write24(spi, lmk04828_init_256[i]);
		mdelay(10);
	}
	printf("lmk04828 total register number=%d\n", i);
	uint8_t val = lmk04828_spi_read(spi, 6);
	printf("lmk04828_reg[6]=%x\n", val);
	return ret;
}

int32_t lmk04828_update_sysref_pulse(spi_device *spi) {
	int ret;
	ret = spi_write24(spi, 0x0144FF);
	ret = spi_write24(spi, 0x014352);
	ret = spi_write24(spi, 0x013902);
	return ret;
}


int32_t lmk04828_update_man_dac(spi_device *spi, uint16_t man_dac) {
	int ret;
	uint16_t value;
	if (man_dac < 500)
		value = 0;
	else if (man_dac > 2700)
		value = 1023;
	else
		value = round((((float) man_dac - 500) * 1023) / 2200);
	//printf("man_dac=%d,dac_value=%d\n", man_dac, value);
	ret = spi_write24(spi, 0x014B1C | ((value >> 8) & 0x3));
	ret = spi_write24(spi, 0x014C00 | (value & 0xff));
	return ret;
}

int32_t lmk04828_get_dac_value(spi_device *spi, uint16_t *man_dac) {
	uint16_t value;
	value = lmk04828_spi_read(spi, 0x184);
	value = ((value & 0xc0) << 2) | (lmk04828_spi_read(spi, 0x185) & 0xff);
	printf("dac_value=%d\n", value);
	*man_dac = (uint16_t) (round((float) value * 2200 / 1024 + 500));
	return 0;
}
int32_t lmk04828_holdover_en(spi_device *spi, uint16_t enable) {
	int ret;
	ret = spi_write24(spi, 0x014B16 | ((enable & 0x1) << 3));
	ret = spi_write24(spi, 0x014C00);
	return ret;
}
int32_t lmk04828_set_sysref_sync_shots(spi_device *spi) {
	int ret;
	ret = spi_write24(spi, 0x016A20);
	return ret;
}
int32_t lmk04828_set_sysref_sync_cont(spi_device *spi) {
	int ret;
	ret = spi_write24(spi, 0x016A60);//0x016A60
	return ret;
}
int32_t lmk04828_set_sysref_shots(spi_device *spi, uint32_t mode) {
	int ret;
	ret = spi_write24(spi, 0x013E00 | (mode & 0x3));
	return ret;
}
int32_t lmk04828_send_sync_pol(spi_device *spi) {
	int ret;
	ret = spi_write24(spi, 0x0143B1);
	ret = spi_write24(spi, 0x014391);
	return ret;
}
int32_t lmk04828_spi_readm(spi_device *spi, uint32_t reg,
		uint8_t *rbuf)
{
	uint8_t buf[3];
	int32_t ret;
	uint16_t cmd;

	cmd = 0x8000 | (reg & 0x1FFF);
	buf[0] = cmd >> 8;
	buf[1] = cmd & 0xFF;
	buf[2] = 0;
	ret = spi_write_and_read(spi, buf, 3);
	*rbuf=buf[2];
	return ret;
}
int32_t lmk04828_spi_read(spi_device *spi, uint32_t reg)
{
	uint8_t buf;
	int32_t ret;

	ret = lmk04828_spi_readm(spi, reg, &buf);
	if (ret < 0)
		return ret;
	return buf;
}
