OpenSourceSDRLab/RFSoC-27DR/vivado/AD_DA_Loopback/AD_DA_LOOP_MTS_PS/AD_DA_LOOP_MTS/src/rfsoc_cfg.h

#ifndef SRC_RFSOC_RFSOC_CFG_H_
#define SRC_RFSOC_RFSOC_CFG_H_
#include "xrfdc.h"

u32 XRFdc_ChangeNCOFreq(XRFdc *InstancePtr, u32 Type, u32 Tile_Id, u32 Block_Id,double Freq_set);
u32 XRFdc_ChangeNCOPhase(XRFdc *InstancePtr, u32 Type, u32 Tile_Id,u32 Block_Id, double Phase_offset);
u32 qmc_settings(XRFdc *RFdcInstPtr, u32 type);

#endif /* SRC_RFSOC_RFSOC_CFG_H_ */
