OpenSourceSDRLab/RFSoC-27DR/vivado/AD_DA_Loopback/AD_DA_LOOP_MTS_PS/AD_DA_LOOP_MTS/src/xrfdc_dcp.h

#include "xrfdc.h"
#ifndef SRC_RFSOC_XRFDC_DCP_H_
#define SRC_RFSOC_XRFDC_DCP_H_
int RFdcDcp_initial(XRFdc *RFdcInstPtr, u16 RFdcDeviceId);
int RFdcDcp_Example(XRFdc *RFdcInstPtr, spi_device * spi);

#endif /* SRC_RFSOC_XRFDC_DCP_H_ */
