OpenSourceSDRLab/RFSoC-27DR/vivado/PL_DDR4_Test/PL_DDR4_Test/PL_DDR4_Test.srcs/cons/pin.xdc

create_debug_core u_ila_0 ila
set_property ALL_PROBE_SAME_MU true [get_debug_cores u_ila_0]
set_property ALL_PROBE_SAME_MU_CNT 4 [get_debug_cores u_ila_0]
set_property C_ADV_TRIGGER true [get_debug_cores u_ila_0]
set_property C_DATA_DEPTH 2048 [get_debug_cores u_ila_0]
set_property C_EN_STRG_QUAL true [get_debug_cores u_ila_0]
set_property C_INPUT_PIPE_STAGES 0 [get_debug_cores u_ila_0]
set_property C_TRIGIN_EN false [get_debug_cores u_ila_0]
set_property C_TRIGOUT_EN false [get_debug_cores u_ila_0]
set_property port_width 1 [get_debug_ports u_ila_0/clk]
connect_debug_port u_ila_0/clk [get_nets [list u_ddr4/inst/u_ddr4_infrastructure/mmcm_clk_in]]
set_property PROBE_TYPE DATA_AND_TRIGGER [get_debug_ports u_ila_0/probe0]
set_property port_width 10 [get_debug_ports u_ila_0/probe0]
connect_debug_port u_ila_0/probe0 [get_nets [list {mem_burst_m0/rd_data_cnt[0]} {mem_burst_m0/rd_data_cnt[1]} {mem_burst_m0/rd_data_cnt[2]} {mem_burst_m0/rd_data_cnt[3]} {mem_burst_m0/rd_data_cnt[4]} {mem_burst_m0/rd_data_cnt[5]} {mem_burst_m0/rd_data_cnt[6]} {mem_burst_m0/rd_data_cnt[7]} {mem_burst_m0/rd_data_cnt[8]} {mem_burst_m0/rd_data_cnt[9]}]]
create_debug_port u_ila_0 probe
set_property PROBE_TYPE DATA_AND_TRIGGER [get_debug_ports u_ila_0/probe1]
set_property port_width 28 [get_debug_ports u_ila_0/probe1]
connect_debug_port u_ila_0/probe1 [get_nets [list {mem_test_m0/rd_burst_addr[0]} {mem_test_m0/rd_burst_addr[1]} {mem_test_m0/rd_burst_addr[2]} {mem_test_m0/rd_burst_addr[3]} {mem_test_m0/rd_burst_addr[4]} {mem_test_m0/rd_burst_addr[5]} {mem_test_m0/rd_burst_addr[6]} {mem_test_m0/rd_burst_addr[7]} {mem_test_m0/rd_burst_addr[8]} {mem_test_m0/rd_burst_addr[9]} {mem_test_m0/rd_burst_addr[10]} {mem_test_m0/rd_burst_addr[11]} {mem_test_m0/rd_burst_addr[12]} {mem_test_m0/rd_burst_addr[13]} {mem_test_m0/rd_burst_addr[14]} {mem_test_m0/rd_burst_addr[15]} {mem_test_m0/rd_burst_addr[16]} {mem_test_m0/rd_burst_addr[17]} {mem_test_m0/rd_burst_addr[18]} {mem_test_m0/rd_burst_addr[19]} {mem_test_m0/rd_burst_addr[20]} {mem_test_m0/rd_burst_addr[21]} {mem_test_m0/rd_burst_addr[22]} {mem_test_m0/rd_burst_addr[23]} {mem_test_m0/rd_burst_addr[24]} {mem_test_m0/rd_burst_addr[25]} {mem_test_m0/rd_burst_addr[26]} {mem_test_m0/rd_burst_addr[27]}]]
create_debug_port u_ila_0 probe
set_property PROBE_TYPE DATA_AND_TRIGGER [get_debug_ports u_ila_0/probe2]
set_property port_width 256 [get_debug_ports u_ila_0/probe2]
connect_debug_port u_ila_0/probe2 [get_nets [list {mem_test_m0/rd_burst_data[0]} {mem_test_m0/rd_burst_data[1]} {mem_test_m0/rd_burst_data[2]} {mem_test_m0/rd_burst_data[3]} {mem_test_m0/rd_burst_data[4]} {mem_test_m0/rd_burst_data[5]} {mem_test_m0/rd_burst_data[6]} {mem_test_m0/rd_burst_data[7]} {m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
create_debug_port u_ila_0 probe
set_property PROBE_TYPE DATA_AND_TRIGGER [get_debug_ports u_ila_0/probe3]
set_property port_width 10 [get_debug_ports u_ila_0/probe3]
connect_debug_port u_ila_0/probe3 [get_nets [list {mem_test_m0/rd_burst_len[0]} {mem_test_m0/rd_burst_len[1]} {mem_test_m0/rd_burst_len[2]} {mem_test_m0/rd_burst_len[3]} {mem_test_m0/rd_burst_len[4]} {mem_test_m0/rd_burst_len[5]} {mem_test_m0/rd_burst_len[6]} {mem_test_m0/rd_burst_len[7]} {mem_test_m0/rd_burst_len[8]} {mem_test_m0/rd_burst_len[9]}]]
create_debug_port u_ila_0 probe
set_property PROBE_TYPE DATA_AND_TRIGGER [get_debug_ports u_ila_0/probe4]
set_property port_width 10 [get_debug_ports u_ila_0/probe4]
connect_debug_port u_ila_0/probe4 [get_nets [list {mem_burst_m0/rd_addr_cnt[0]} {mem_burst_m0/rd_addr_cnt[1]} {mem_burst_m0/rd_addr_cnt[2]} {mem_burst_m0/rd_addr_cnt[3]} {mem_burst_m0/rd_addr_cnt[4]} {mem_burst_m0/rd_addr_cnt[5]} {mem_burst_m0/rd_addr_cnt[6]} {mem_burst_m0/rd_addr_cnt[7]} {mem_burst_m0/rd_addr_cnt[8]} {mem_burst_m0/rd_addr_cnt[9]}]]
create_debug_port u_ila_0 probe
set_property PROBE_TYPE DATA_AND_TRIGGER [get_debug_ports u_ila_0/probe5]
set_property port_width 256 [get_debug_ports u_ila_0/probe5]
connect_debug_port u_ila_0/probe5 [get_nets [list {mem_burst_m0/app_wdf_data[0]} {mem_burst_m0/app_wdf_data[1]} {mem_burst_m0/app_wdf_data[2]} {mem_burst_m0/app_wdf_data[3]} {mem_burst_m0/app_wdf_data[4]} {mem_burst_m0/app_wdf_data[5]} {mem_burst_m0/app_wdf_data[6]} {mem_burst_m0/app_wdf_data[7]} {mem_burst_m0/app_wdf_data[8]} {mem_burst_m0/app_wdf_data[9]} {mem_burst_m0/app_wdf_data[10]} {mem_burst_m0/app_wdf_data[11]} {mem_burst_m0/app_wdf_data[12]} {mem_burst_m0/app_wdf_data[13]} {mem_burst_m0/app_wdf_data[14]} {mem_burst_m0/app_wdf_data[15]} {mem_burst_m0/app_wdf_data[16]} {mem_burst_m0/app_wdf_data[17]} {mem_burst_m0/app_wdf_data[18]} {mem_burst_m0/app_wdf_data[19]} {mem_burst_m0/app_wdf_data[20]} {mem_burst_m0/app_wdf_data[21]} {mem_burst_m0/app_wdf_data[22]} {mem_burst_m0/app_wdf_data[23]} {mem_burst_m0/app_wdf_data[24]} {mem_burst_m0/app_wdf_data[25]} {mem_burst_m0/app_wdf_data[26]} {mem_burst_m0/app_wdf_data[27]} {mem_burst_m0/app_wdf_data[28]} {mem_burst_m0/app_wdf_data[29]} {mem_burst_m0/app_wdf_data[30]} {mem_burst_m0/app_wdf_data[31]} {mem_burst_m0/app_wdf_data[32]} {mem_burst_m0/app_wdf_data[33]} {mem_burst_m0/app_wdf_data[34]} {mem_burst_m0/app_wdf_data[35]} {mem_burst_m0/app_wdf_data[36]} {mem_burst_m0/app_wdf_data[37]} {mem_burst_m0/app_wdf_data[38]} {mem_burst_m0/app_wdf_data[39]} {mem_burst_m0/app_wdf_data[40]} {mem_burst_m0/app_wdf_data[41]} {mem_burst_m0/app_wdf_data[42]} {mem_burst_m0/app_wdf_data[43]} {mem_burst_m0/app_wdf_data[44]} {mem_burst_m0/app_wd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
_data[183]} {mem_burst_m0/app_wdf_data[184]} {mem_burst_m0/app_wdf_data[185]} {mem_burst_m0/app_wdf_data[186]} {mem_burst_m0/app_wdf_data[187]} {mem_burst_m0/app_wdf_data[188]} {mem_burst_m0/app_wdf_data[189]} {mem_burst_m0/app_wdf_data[190]} {mem_burst_m0/app_wdf_data[191]} {mem_burst_m0/app_wdf_data[192]} {mem_burst_m0/app_wdf_data[193]} {mem_burst_m0/app_wdf_data[194]} {mem_burst_m0/app_wdf_data[195]} {mem_burst_m0/app_wdf_data[196]} {mem_burst_m0/app_wdf_data[197]} {mem_burst_m0/app_wdf_data[198]} {mem_burst_m0/app_wdf_data[199]} {mem_burst_m0/app_wdf_data[200]} {mem_burst_m0/app_wdf_data[201]} {mem_burst_m0/app_wdf_data[202]} {mem_burst_m0/app_wdf_data[203]} {mem_burst_m0/app_wdf_data[204]} {mem_burst_m0/app_wdf_data[205]} {mem_burst_m0/app_wdf_data[206]} {mem_burst_m0/app_wdf_data[207]} {mem_burst_m0/app_wdf_data[208]} {mem_burst_m0/app_wdf_data[209]} {mem_burst_m0/app_wdf_data[210]} {mem_burst_m0/app_wdf_data[211]} {mem_burst_m0/app_wdf_data[212]} {mem_burst_m0/app_wdf_data[213]} {mem_burst_m0/app_wdf_data[214]} {mem_burst_m0/app_wdf_data[215]} {mem_burst_m0/app_wdf_data[216]} {mem_burst_m0/app_wdf_data[217]} {mem_burst_m0/app_wdf_data[218]} {mem_burst_m0/app_wdf_data[219]} {mem_burst_m0/app_wdf_data[220]} {mem_burst_m0/app_wdf_data[221]} {mem_burst_m0/app_wdf_data[222]} {mem_burst_m0/app_wdf_data[223]} {mem_burst_m0/app_wdf_data[224]} {mem_burst_m0/app_wdf_data[225]} {mem_burst_m0/app_wdf_data[226]} {mem_burst_m0/app_wdf_data[227]} {mem_burst_m0/app_wdf_data[228]} {mem_burst_m0/app_wdf_data[229]} {mem_burst_m0/app_wdf_data[230]} {mem_burst_m0/app_wdf_data[231]} {mem_burst_m0/app_wdf_data[232]} {mem_burst_m0/app_wdf_data[233]} {mem_burst_m0/app_wdf_data[234]} {mem_burst_m0/app_wdf_data[235]} {mem_burst_m0/app_wdf_data[236]} {mem_burst_m0/app_wdf_data[237]} {mem_burst_m0/app_wdf_data[238]} {mem_burst_m0/app_wdf_data[239]} {mem_burst_m0/app_wdf_data[240]} {mem_burst_m0/app_wdf_data[241]} {mem_burst_m0/app_wdf_data[242]} {mem_burst_m0/app_wdf_data[243]} {mem_burst_m0/app_wdf_data[244]} {mem_burst_m0/app_wdf_data[245]} {mem_burst_m0/app_wdf_data[246]} {mem_burst_m0/app_wdf_data[247]} {mem_burst_m0/app_wdf_data[248]} {mem_burst_m0/app_wdf_data[249]} {mem_burst_m0/app_wdf_data[250]} {mem_burst_m0/app_wdf_data[251]} {mem_burst_m0/app_wdf_data[252]} {mem_burst_m0/app_wdf_data[253]} {mem_burst_m0/app_wdf_data[254]} {mem_burst_m0/app_wdf_data[255]}]]
create_debug_port u_ila_0 probe
set_property PROBE_TYPE DATA_AND_TRIGGER [get_debug_ports u_ila_0/probe6]
set_property port_width 10 [get_debug_ports u_ila_0/probe6]
connect_debug_port u_ila_0/probe6 [get_nets [list {mem_burst_m0/wr_data_cnt[0]} {mem_burst_m0/wr_data_cnt[1]} {mem_burst_m0/wr_data_cnt[2]} {mem_burst_m0/wr_data_cnt[3]} {mem_burst_m0/wr_data_cnt[4]} {mem_burst_m0/wr_data_cnt[5]} {mem_burst_m0/wr_data_cnt[6]} {mem_burst_m0/wr_data_cnt[7]} {mem_burst_m0/wr_data_cnt[8]} {mem_burst_m0/wr_data_cnt[9]}]]
create_debug_port u_ila_0 probe
set_property PROBE_TYPE DATA_AND_TRIGGER [get_debug_ports u_ila_0/probe7]
set_property port_width 10 [get_debug_ports u_ila_0/probe7]
connect_debug_port u_ila_0/probe7 [get_nets [list {mem_test_m0/rd_cnt[0]} {mem_test_m0/rd_cnt[1]} {mem_test_m0/rd_cnt[2]} {mem_test_m0/rd_cnt[3]} {mem_test_m0/rd_cnt[4]} {mem_test_m0/rd_cnt[5]} {mem_test_m0/rd_cnt[6]} {mem_test_m0/rd_cnt[7]} {mem_test_m0/rd_cnt[8]} {mem_test_m0/rd_cnt[9]}]]
create_debug_port u_ila_0 probe
set_property PROBE_TYPE DATA_AND_TRIGGER [get_debug_ports u_ila_0/probe8]
set_property port_width 3 [get_debug_ports u_ila_0/probe8]
connect_debug_port u_ila_0/probe8 [get_nets [list {mem_burst_m0/app_cmd[0]} {mem_burst_m0/app_cmd[1]} {mem_burst_m0/app_cmd[2]}]]
create_debug_port u_ila_0 probe
set_property PROBE_TYPE DATA_AND_TRIGGER [get_debug_ports u_ila_0/probe9]
set_property port_width 29 [get_debug_ports u_ila_0/probe9]
connect_debug_port u_ila_0/probe9 [get_nets [list {mem_burst_m0/app_addr[0]} {mem_burst_m0/app_addr[1]} {mem_burst_m0/app_addr[2]} {mem_burst_m0/app_addr[3]} {mem_burst_m0/app_addr[4]} {mem_burst_m0/app_addr[5]} {mem_burst_m0/app_addr[6]} {mem_burst_m0/app_addr[7]} {mem_burst_m0/app_addr[8]} {mem_burst_m0/app_addr[9]} {mem_burst_m0/app_addr[10]} {mem_burst_m0/app_addr[11]} {mem_burst_m0/app_addr[12]} {mem_burst_m0/app_addr[13]} {mem_burst_m0/app_addr[14]} {mem_burst_m0/app_addr[15]} {mem_burst_m0/app_addr[16]} {mem_burst_m0/app_addr[17]} {mem_burst_m0/app_addr[18]} {mem_burst_m0/app_addr[19]} {mem_burst_m0/app_addr[20]} {mem_burst_m0/app_addr[21]} {mem_burst_m0/app_addr[22]} {mem_burst_m0/app_addr[23]} {mem_burst_m0/app_addr[24]} {mem_burst_m0/app_addr[25]} {mem_burst_m0/app_addr[26]} {mem_burst_m0/app_addr[27]} {mem_burst_m0/app_addr[28]}]]
create_debug_port u_ila_0 probe
set_property PROBE_TYPE DATA_AND_TRIGGER [get_debug_ports u_ila_0/probe10]
set_property port_width 3 [get_debug_ports u_ila_0/probe10]
connect_debug_port u_ila_0/probe10 [get_nets [list {mem_burst_m0/state[0]} {mem_burst_m0/state[1]} {mem_burst_m0/state[2]}]]
create_debug_port u_ila_0 probe
set_property PROBE_TYPE DATA_AND_TRIGGER [get_debug_ports u_ila_0/probe11]
set_property port_width 10 [get_debug_ports u_ila_0/probe11]
connect_debug_port u_ila_0/probe11 [get_nets [list {mem_burst_m0/wr_addr_cnt[0]} {mem_burst_m0/wr_addr_cnt[1]} {mem_burst_m0/wr_addr_cnt[2]} {mem_burst_m0/wr_addr_cnt[3]} {mem_burst_m0/wr_addr_cnt[4]} {mem_burst_m0/wr_addr_cnt[5]} {mem_burst_m0/wr_addr_cnt[6]} {mem_burst_m0/wr_addr_cnt[7]} {mem_burst_m0/wr_addr_cnt[8]} {mem_burst_m0/wr_addr_cnt[9]}]]
create_debug_port u_ila_0 probe
set_property PROBE_TYPE DATA_AND_TRIGGER [get_debug_ports u_ila_0/probe12]
set_property port_width 256 [get_debug_ports u_ila_0/probe12]
connect_debug_port u_ila_0/probe12 [get_nets [list {mem_burst_m0/app_rd_data[0]} {mem_burst_m0/app_rd_data[1]} {mem_burst_m0/app_rd_data[2]} {mem_burst_m0/app_rd_data[3]} {mem_burst_m0/app_rd_data[4]} {mem_burst_m0/app_rd_data[5]} {mem_burst_m0/app_rd_data[6]} {mem_burst_m0/app_rd_data[7]} {mem_burst_m0/app_rd_data[8]} {mem_burst_m0/app_rd_data[9]} {mem_burst_m0/app_rd_data[10]} {mem_burst_m0/app_rd_data[11]} {mem_burst_m0/app_rd_data[12]} {mem_burst_m0/app_rd_data[13]} {mem_burst_m0/app_rd_data[14]} {mem_burst_m0/app_rd_data[15]} {mem_burst_m0/app_rd_data[16]} {mem_burst_m0/app_rd_data[17]} {mem_burst_m0/app_rd_data[18]} {mem_burst_m0/app_rd_data[19]} {mem_burst_m0/app_rd_data[20]} {mem_burst_m0/app_rd_data[21]} {mem_burst_m0/app_rd_data[22]} {mem_burst_m0/app_rd_data[23]} {mem_burst_m0/app_rd_data[24]} {mem_burst_m0/app_rd_data[25]} {mem_burst_m0/app_rd_data[26]} {mem_burst_m0/app_rd_data[27]} {mem_burst_m0/app_rd_data[28]} {mem_burst_m0/app_rd_data[29]} {mem_burst_m0/app_rd_data[30]} {mem_burst_m0/app_rd_data[31]} {mem_burst_m0/app_rd_data[32]} {mem_burst_m0/app_rd_data[33]} {mem_burst_m0/app_rd_data[34]} {mem_burst_m0/app_rd_data[35]} {mem_burst_m0/app_rd_data[36]} {mem_burst_m0/app_rd_data[37]} {mem_burst_m0/app_rd_data[38]} {mem_burst_m0/app_rd_data[39]} {mem_burst_m0/app_rd_data[40]} {mem_burst_m0/app_rd_data[41]} {mem_burst_m0/app_rd_data[42]} {mem_burst_m0/app_rd_data[43]} {mem_burst_m0/app_rd_data[44]} {mem_burst_m0/app_rd_data[45]} {mem_burst_m0/app_rd_data[46]} {m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
m0/app_rd_data[189]} {mem_burst_m0/app_rd_data[190]} {mem_burst_m0/app_rd_data[191]} {mem_burst_m0/app_rd_data[192]} {mem_burst_m0/app_rd_data[193]} {mem_burst_m0/app_rd_data[194]} {mem_burst_m0/app_rd_data[195]} {mem_burst_m0/app_rd_data[196]} {mem_burst_m0/app_rd_data[197]} {mem_burst_m0/app_rd_data[198]} {mem_burst_m0/app_rd_data[199]} {mem_burst_m0/app_rd_data[200]} {mem_burst_m0/app_rd_data[201]} {mem_burst_m0/app_rd_data[202]} {mem_burst_m0/app_rd_data[203]} {mem_burst_m0/app_rd_data[204]} {mem_burst_m0/app_rd_data[205]} {mem_burst_m0/app_rd_data[206]} {mem_burst_m0/app_rd_data[207]} {mem_burst_m0/app_rd_data[208]} {mem_burst_m0/app_rd_data[209]} {mem_burst_m0/app_rd_data[210]} {mem_burst_m0/app_rd_data[211]} {mem_burst_m0/app_rd_data[212]} {mem_burst_m0/app_rd_data[213]} {mem_burst_m0/app_rd_data[214]} {mem_burst_m0/app_rd_data[215]} {mem_burst_m0/app_rd_data[216]} {mem_burst_m0/app_rd_data[217]} {mem_burst_m0/app_rd_data[218]} {mem_burst_m0/app_rd_data[219]} {mem_burst_m0/app_rd_data[220]} {mem_burst_m0/app_rd_data[221]} {mem_burst_m0/app_rd_data[222]} {mem_burst_m0/app_rd_data[223]} {mem_burst_m0/app_rd_data[224]} {mem_burst_m0/app_rd_data[225]} {mem_burst_m0/app_rd_data[226]} {mem_burst_m0/app_rd_data[227]} {mem_burst_m0/app_rd_data[228]} {mem_burst_m0/app_rd_data[229]} {mem_burst_m0/app_rd_data[230]} {mem_burst_m0/app_rd_data[231]} {mem_burst_m0/app_rd_data[232]} {mem_burst_m0/app_rd_data[233]} {mem_burst_m0/app_rd_data[234]} {mem_burst_m0/app_rd_data[235]} {mem_burst_m0/app_rd_data[236]} {mem_burst_m0/app_rd_data[237]} {mem_burst_m0/app_rd_data[238]} {mem_burst_m0/app_rd_data[239]} {mem_burst_m0/app_rd_data[240]} {mem_burst_m0/app_rd_data[241]} {mem_burst_m0/app_rd_data[242]} {mem_burst_m0/app_rd_data[243]} {mem_burst_m0/app_rd_data[244]} {mem_burst_m0/app_rd_data[245]} {mem_burst_m0/app_rd_data[246]} {mem_burst_m0/app_rd_data[247]} {mem_burst_m0/app_rd_data[248]} {mem_burst_m0/app_rd_data[249]} {mem_burst_m0/app_rd_data[250]} {mem_burst_m0/app_rd_data[251]} {mem_burst_m0/app_rd_data[252]} {mem_burst_m0/app_rd_data[253]} {mem_burst_m0/app_rd_data[254]} {mem_burst_m0/app_rd_data[255]}]]
create_debug_port u_ila_0 probe
set_property PROBE_TYPE DATA_AND_TRIGGER [get_debug_ports u_ila_0/probe13]
set_property port_width 256 [get_debug_ports u_ila_0/probe13]
connect_debug_port u_ila_0/probe13 [get_nets [list {rd_burst_data[0]} {rd_burst_data[1]} {rd_burst_data[2]} {rd_burst_data[3]} {rd_burst_data[4]} {rd_burst_data[5]} {rd_burst_data[6]} {rd_burst_data[7]} {rd_burst_data[8]} {rd_burst_data[9]} {rd_burst_data[10]} {rd_burst_data[11]} {rd_burst_data[12]}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
create_debug_port u_ila_0 probe
set_property PROBE_TYPE DATA_AND_TRIGGER [get_debug_ports u_ila_0/probe14]
set_property port_width 10 [get_debug_ports u_ila_0/probe14]
connect_debug_port u_ila_0/probe14 [get_nets [list {rd_burst_len[0]} {rd_burst_len[1]} {rd_burst_len[2]} {rd_burst_len[3]} {rd_burst_len[4]} {rd_burst_len[5]} {rd_burst_len[6]} {rd_burst_len[7]} {rd_burst_len[8]} {rd_burst_len[9]}]]
create_debug_port u_ila_0 probe
set_property PROBE_TYPE DATA_AND_TRIGGER [get_debug_ports u_ila_0/probe15]
set_property port_width 10 [get_debug_ports u_ila_0/probe15]
connect_debug_port u_ila_0/probe15 [get_nets [list {mem_test_m0/wr_burst_len[0]} {mem_test_m0/wr_burst_len[1]} {mem_test_m0/wr_burst_len[2]} {mem_test_m0/wr_burst_len[3]} {mem_test_m0/wr_burst_len[4]} {mem_test_m0/wr_burst_len[5]} {mem_test_m0/wr_burst_len[6]} {mem_test_m0/wr_burst_len[7]} {mem_test_m0/wr_burst_len[8]} {mem_test_m0/wr_burst_len[9]}]]
create_debug_port u_ila_0 probe
set_property PROBE_TYPE DATA_AND_TRIGGER [get_debug_ports u_ila_0/probe16]
set_property port_width 3 [get_debug_ports u_ila_0/probe16]
connect_debug_port u_ila_0/probe16 [get_nets [list {mem_test_m0/state[0]} {mem_test_m0/state[1]} {mem_test_m0/state[2]}]]
create_debug_port u_ila_0 probe
set_property PROBE_TYPE DATA_AND_TRIGGER [get_debug_ports u_ila_0/probe17]
set_property port_width 256 [get_debug_ports u_ila_0/probe17]
connect_debug_port u_ila_0/probe17 [get_nets [list {mem_test_m0/wr_burst_data[0]} {mem_test_m0/wr_burst_data[1]} {mem_test_m0/wr_burst_data[2]} {mem_test_m0/wr_burst_data[3]} {mem_test_m0/wr_burst_data[4]} {mem_test_m0/wr_burst_data[5]} {mem_test_m0/wr_burst_data[6]} {mem_test_m0/wr_burst_data[7]} {mem_test_m0/wr_burst_data[8]} {mem_test_m0/wr_burst_data[9]} {mem_test_m0/wr_burst_data[10]} {mem_test_m0/wr_burst_data[11]} {mem_test_m0/wr_burst_data[12]} {mem_test_m0/wr_burst_data[13]} {mem_test_m0/wr_burst_data[14]} {mem_test_m0/wr_burst_data[15]} {mem_test_m0/wr_burst_data[16]} {mem_test_m0/wr_burst_data[17]} {mem_test_m0/wr_burst_data[18]} {mem_test_m0/wr_burst_data[19]} {mem_test_m0/wr_burst_data[20]} {mem_test_m0/wr_burst_data[21]} {mem_test_m0/wr_burst_data[22]} {mem_test_m0/wr_burst_data[23]} {mem_test_m0/wr_burst_data[24]} {mem_test_m0/wr_burst_data[25]} {mem_test_m0/wr_burst_data[26]} {mem_test_m0/wr_burst_data[27]} {mem_test_m0/wr_burst_data[28]} {mem_test_m0/wr_burst_data[29]} {mem_test_m0/wr_burst_data[30]} {mem_test_m0/wr_burst_data[31]} {mem_test_m0/wr_burst_data[32]} {mem_test_m0/wr_burst_data[33]} {mem_test_m0/wr_burst_data[34]} {mem_test_m0/wr_burst_data[35]} {mem_test_m0/wr_burst_data[36]} {mem_test_m0/wr_burst_data[37]} {mem_test_m0/wr_burst_data[38]} {mem_test_m0/wr_burst_data[39]} {mem_test_m0/wr_burst_data[40]} {mem_test_m0/wr_burst_data[41]} {mem_test_m0/wr_burst_data[42]} {mem_test_m0/wr_burst_data[43]} {mem_test_m0/wr_burst_data[44]} {mem_test_m0/wr_bur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
t_data[183]} {mem_test_m0/wr_burst_data[184]} {mem_test_m0/wr_burst_data[185]} {mem_test_m0/wr_burst_data[186]} {mem_test_m0/wr_burst_data[187]} {mem_test_m0/wr_burst_data[188]} {mem_test_m0/wr_burst_data[189]} {mem_test_m0/wr_burst_data[190]} {mem_test_m0/wr_burst_data[191]} {mem_test_m0/wr_burst_data[192]} {mem_test_m0/wr_burst_data[193]} {mem_test_m0/wr_burst_data[194]} {mem_test_m0/wr_burst_data[195]} {mem_test_m0/wr_burst_data[196]} {mem_test_m0/wr_burst_data[197]} {mem_test_m0/wr_burst_data[198]} {mem_test_m0/wr_burst_data[199]} {mem_test_m0/wr_burst_data[200]} {mem_test_m0/wr_burst_data[201]} {mem_test_m0/wr_burst_data[202]} {mem_test_m0/wr_burst_data[203]} {mem_test_m0/wr_burst_data[204]} {mem_test_m0/wr_burst_data[205]} {mem_test_m0/wr_burst_data[206]} {mem_test_m0/wr_burst_data[207]} {mem_test_m0/wr_burst_data[208]} {mem_test_m0/wr_burst_data[209]} {mem_test_m0/wr_burst_data[210]} {mem_test_m0/wr_burst_data[211]} {mem_test_m0/wr_burst_data[212]} {mem_test_m0/wr_burst_data[213]} {mem_test_m0/wr_burst_data[214]} {mem_test_m0/wr_burst_data[215]} {mem_test_m0/wr_burst_data[216]} {mem_test_m0/wr_burst_data[217]} {mem_test_m0/wr_burst_data[218]} {mem_test_m0/wr_burst_data[219]} {mem_test_m0/wr_burst_data[220]} {mem_test_m0/wr_burst_data[221]} {mem_test_m0/wr_burst_data[222]} {mem_test_m0/wr_burst_data[223]} {mem_test_m0/wr_burst_data[224]} {mem_test_m0/wr_burst_data[225]} {mem_test_m0/wr_burst_data[226]} {mem_test_m0/wr_burst_data[227]} {mem_test_m0/wr_burst_data[228]} {mem_test_m0/wr_burst_data[229]} {mem_test_m0/wr_burst_data[230]} {mem_test_m0/wr_burst_data[231]} {mem_test_m0/wr_burst_data[232]} {mem_test_m0/wr_burst_data[233]} {mem_test_m0/wr_burst_data[234]} {mem_test_m0/wr_burst_data[235]} {mem_test_m0/wr_burst_data[236]} {mem_test_m0/wr_burst_data[237]} {mem_test_m0/wr_burst_data[238]} {mem_test_m0/wr_burst_data[239]} {mem_test_m0/wr_burst_data[240]} {mem_test_m0/wr_burst_data[241]} {mem_test_m0/wr_burst_data[242]} {mem_test_m0/wr_burst_data[243]} {mem_test_m0/wr_burst_data[244]} {mem_test_m0/wr_burst_data[245]} {mem_test_m0/wr_burst_data[246]} {mem_test_m0/wr_burst_data[247]} {mem_test_m0/wr_burst_data[248]} {mem_test_m0/wr_burst_data[249]} {mem_test_m0/wr_burst_data[250]} {mem_test_m0/wr_burst_data[251]} {mem_test_m0/wr_burst_data[252]} {mem_test_m0/wr_burst_data[253]} {mem_test_m0/wr_burst_data[254]} {mem_test_m0/wr_burst_data[255]}]]
create_debug_port u_ila_0 probe
set_property PROBE_TYPE DATA_AND_TRIGGER [get_debug_ports u_ila_0/probe18]
set_property port_width 256 [get_debug_ports u_ila_0/probe18]
connect_debug_port u_ila_0/probe18 [get_nets [list {wr_burst_data[0]} {wr_burst_data[1]} {wr_burst_data[2]} {wr_burst_data[3]} {wr_burst_data[4]} {wr_burst_data[5]} {wr_burst_data[6]} {wr_burst_data[7]} {wr_burst_data[8]} {wr_burst_data[9]} {wr_burst_data[10]} {wr_burst_data[11]} {wr_burst_data[12]}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
create_debug_port u_ila_0 probe
set_property PROBE_TYPE DATA_AND_TRIGGER [get_debug_ports u_ila_0/probe19]
set_property port_width 10 [get_debug_ports u_ila_0/probe19]
connect_debug_port u_ila_0/probe19 [get_nets [list {mem_test_m0/wr_cnt[0]} {mem_test_m0/wr_cnt[1]} {mem_test_m0/wr_cnt[2]} {mem_test_m0/wr_cnt[3]} {mem_test_m0/wr_cnt[4]} {mem_test_m0/wr_cnt[5]} {mem_test_m0/wr_cnt[6]} {mem_test_m0/wr_cnt[7]} {mem_test_m0/wr_cnt[8]} {mem_test_m0/wr_cnt[9]}]]
create_debug_port u_ila_0 probe
set_property PROBE_TYPE DATA_AND_TRIGGER [get_debug_ports u_ila_0/probe20]
set_property port_width 10 [get_debug_ports u_ila_0/probe20]
connect_debug_port u_ila_0/probe20 [get_nets [list {wr_burst_len[0]} {wr_burst_len[1]} {wr_burst_len[2]} {wr_burst_len[3]} {wr_burst_len[4]} {wr_burst_len[5]} {wr_burst_len[6]} {wr_burst_len[7]} {wr_burst_len[8]} {wr_burst_len[9]}]]
create_debug_port u_ila_0 probe
set_property PROBE_TYPE DATA_AND_TRIGGER [get_debug_ports u_ila_0/probe21]
set_property port_width 16 [get_debug_ports u_ila_0/probe21]
connect_debug_port u_ila_0/probe21 [get_nets [list {mem_test_m0/test_cnt[0]} {mem_test_m0/test_cnt[1]} {mem_test_m0/test_cnt[2]} {mem_test_m0/test_cnt[3]} {mem_test_m0/test_cnt[4]} {mem_test_m0/test_cnt[5]} {mem_test_m0/test_cnt[6]} {mem_test_m0/test_cnt[7]} {mem_test_m0/test_cnt[8]} {mem_test_m0/test_cnt[9]} {mem_test_m0/test_cnt[10]} {mem_test_m0/test_cnt[11]} {mem_test_m0/test_cnt[12]} {mem_test_m0/test_cnt[13]} {mem_test_m0/test_cnt[14]} {mem_test_m0/test_cnt[15]}]]
create_debug_port u_ila_0 probe
set_property PROBE_TYPE DATA_AND_TRIGGER [get_debug_ports u_ila_0/probe22]
set_property port_width 28 [get_debug_ports u_ila_0/probe22]
connect_debug_port u_ila_0/probe22 [get_nets [list {wr_burst_addr[0]} {wr_burst_addr[1]} {wr_burst_addr[2]} {wr_burst_addr[3]} {wr_burst_addr[4]} {wr_burst_addr[5]} {wr_burst_addr[6]} {wr_burst_addr[7]} {wr_burst_addr[8]} {wr_burst_addr[9]} {wr_burst_addr[10]} {wr_burst_addr[11]} {wr_burst_addr[12]} {wr_burst_addr[13]} {wr_burst_addr[14]} {wr_burst_addr[15]} {wr_burst_addr[16]} {wr_burst_addr[17]} {wr_burst_addr[18]} {wr_burst_addr[19]} {wr_burst_addr[20]} {wr_burst_addr[21]} {wr_burst_addr[22]} {wr_burst_addr[23]} {wr_burst_addr[24]} {wr_burst_addr[25]} {wr_burst_addr[26]} {wr_burst_addr[27]}]]
create_debug_port u_ila_0 probe
set_property PROBE_TYPE DATA_AND_TRIGGER [get_debug_ports u_ila_0/probe23]
set_property port_width 28 [get_debug_ports u_ila_0/probe23]
connect_debug_port u_ila_0/probe23 [get_nets [list {rd_burst_addr[0]} {rd_burst_addr[1]} {rd_burst_addr[2]} {rd_burst_addr[3]} {rd_burst_addr[4]} {rd_burst_addr[5]} {rd_burst_addr[6]} {rd_burst_addr[7]} {rd_burst_addr[8]} {rd_burst_addr[9]} {rd_burst_addr[10]} {rd_burst_addr[11]} {rd_burst_addr[12]} {rd_burst_addr[13]} {rd_burst_addr[14]} {rd_burst_addr[15]} {rd_burst_addr[16]} {rd_burst_addr[17]} {rd_burst_addr[18]} {rd_burst_addr[19]} {rd_burst_addr[20]} {rd_burst_addr[21]} {rd_burst_addr[22]} {rd_burst_addr[23]} {rd_burst_addr[24]} {rd_burst_addr[25]} {rd_burst_addr[26]} {rd_burst_addr[27]}]]
create_debug_port u_ila_0 probe
set_property PROBE_TYPE DATA_AND_TRIGGER [get_debug_ports u_ila_0/probe24]
set_property port_width 16 [get_debug_ports u_ila_0/probe24]
connect_debug_port u_ila_0/probe24 [get_nets [list {mem_test_m0/rd_data_pre_add[0]} {mem_test_m0/rd_data_pre_add[1]} {mem_test_m0/rd_data_pre_add[2]} {mem_test_m0/rd_data_pre_add[3]} {mem_test_m0/rd_data_pre_add[4]} {mem_test_m0/rd_data_pre_add[5]} {mem_test_m0/rd_data_pre_add[6]} {mem_test_m0/rd_data_pre_add[7]} {mem_test_m0/rd_data_pre_add[8]} {mem_test_m0/rd_data_pre_add[9]} {mem_test_m0/rd_data_pre_add[10]} {mem_test_m0/rd_data_pre_add[11]} {mem_test_m0/rd_data_pre_add[12]} {mem_test_m0/rd_data_pre_add[13]} {mem_test_m0/rd_data_pre_add[14]} {mem_test_m0/rd_data_pre_add[15]}]]
create_debug_port u_ila_0 probe
set_property PROBE_TYPE DATA_AND_TRIGGER [get_debug_ports u_ila_0/probe25]
set_property port_width 28 [get_debug_ports u_ila_0/probe25]
connect_debug_port u_ila_0/probe25 [get_nets [list {mem_test_m0/wr_burst_addr[0]} {mem_test_m0/wr_burst_addr[1]} {mem_test_m0/wr_burst_addr[2]} {mem_test_m0/wr_burst_addr[3]} {mem_test_m0/wr_burst_addr[4]} {mem_test_m0/wr_burst_addr[5]} {mem_test_m0/wr_burst_addr[6]} {mem_test_m0/wr_burst_addr[7]} {mem_test_m0/wr_burst_addr[8]} {mem_test_m0/wr_burst_addr[9]} {mem_test_m0/wr_burst_addr[10]} {mem_test_m0/wr_burst_addr[11]} {mem_test_m0/wr_burst_addr[12]} {mem_test_m0/wr_burst_addr[13]} {mem_test_m0/wr_burst_addr[14]} {mem_test_m0/wr_burst_addr[15]} {mem_test_m0/wr_burst_addr[16]} {mem_test_m0/wr_burst_addr[17]} {mem_test_m0/wr_burst_addr[18]} {mem_test_m0/wr_burst_addr[19]} {mem_test_m0/wr_burst_addr[20]} {mem_test_m0/wr_burst_addr[21]} {mem_test_m0/wr_burst_addr[22]} {mem_test_m0/wr_burst_addr[23]} {mem_test_m0/wr_burst_addr[24]} {mem_test_m0/wr_burst_addr[25]} {mem_test_m0/wr_burst_addr[26]} {mem_test_m0/wr_burst_addr[27]}]]
create_debug_port u_ila_0 probe
set_property PROBE_TYPE DATA_AND_TRIGGER [get_debug_ports u_ila_0/probe26]
set_property port_width 16 [get_debug_ports u_ila_0/probe26]
connect_debug_port u_ila_0/probe26 [get_nets [list {mem_test_m0/wr_data_pre_add[0]} {mem_test_m0/wr_data_pre_add[1]} {mem_test_m0/wr_data_pre_add[2]} {mem_test_m0/wr_data_pre_add[3]} {mem_test_m0/wr_data_pre_add[4]} {mem_test_m0/wr_data_pre_add[5]} {mem_test_m0/wr_data_pre_add[6]} {mem_test_m0/wr_data_pre_add[7]} {mem_test_m0/wr_data_pre_add[8]} {mem_test_m0/wr_data_pre_add[9]} {mem_test_m0/wr_data_pre_add[10]} {mem_test_m0/wr_data_pre_add[11]} {mem_test_m0/wr_data_pre_add[12]} {mem_test_m0/wr_data_pre_add[13]} {mem_test_m0/wr_data_pre_add[14]} {mem_test_m0/wr_data_pre_add[15]}]]
create_debug_port u_ila_0 probe
set_property PROBE_TYPE DATA_AND_TRIGGER [get_debug_ports u_ila_0/probe27]
set_property port_width 1 [get_debug_ports u_ila_0/probe27]
connect_debug_port u_ila_0/probe27 [get_nets [list mem_burst_m0/app_en]]
create_debug_port u_ila_0 probe
set_property PROBE_TYPE DATA_AND_TRIGGER [get_debug_ports u_ila_0/probe28]
set_property port_width 1 [get_debug_ports u_ila_0/probe28]
connect_debug_port u_ila_0/probe28 [get_nets [list mem_burst_m0/app_rd_data_end]]
create_debug_port u_ila_0 probe
set_property PROBE_TYPE DATA_AND_TRIGGER [get_debug_ports u_ila_0/probe29]
set_property port_width 1 [get_debug_ports u_ila_0/probe29]
connect_debug_port u_ila_0/probe29 [get_nets [list mem_burst_m0/app_rd_data_valid]]
create_debug_port u_ila_0 probe
set_property PROBE_TYPE DATA_AND_TRIGGER [get_debug_ports u_ila_0/probe30]
set_property port_width 1 [get_debug_ports u_ila_0/probe30]
connect_debug_port u_ila_0/probe30 [get_nets [list mem_burst_m0/app_rdy]]
create_debug_port u_ila_0 probe
set_property PROBE_TYPE DATA_AND_TRIGGER [get_debug_ports u_ila_0/probe31]
set_property port_width 1 [get_debug_ports u_ila_0/probe31]
connect_debug_port u_ila_0/probe31 [get_nets [list mem_burst_m0/app_wdf_end]]
create_debug_port u_ila_0 probe
set_property PROBE_TYPE DATA_AND_TRIGGER [get_debug_ports u_ila_0/probe32]
set_property port_width 1 [get_debug_ports u_ila_0/probe32]
connect_debug_port u_ila_0/probe32 [get_nets [list mem_burst_m0/app_wdf_rdy]]
create_debug_port u_ila_0 probe
set_property PROBE_TYPE DATA_AND_TRIGGER [get_debug_ports u_ila_0/probe33]
set_property port_width 1 [get_debug_ports u_ila_0/probe33]
connect_debug_port u_ila_0/probe33 [get_nets [list mem_test_m0/error]]
create_debug_port u_ila_0 probe
set_property PROBE_TYPE DATA_AND_TRIGGER [get_debug_ports u_ila_0/probe34]
set_property port_width 1 [get_debug_ports u_ila_0/probe34]
connect_debug_port u_ila_0/probe34 [get_nets [list error]]
create_debug_port u_ila_0 probe
set_property PROBE_TYPE DATA_AND_TRIGGER [get_debug_ports u_ila_0/probe35]
set_property port_width 1 [get_debug_ports u_ila_0/probe35]
connect_debug_port u_ila_0/probe35 [get_nets [list init_calib_complete]]
create_debug_port u_ila_0 probe
set_property PROBE_TYPE DATA_AND_TRIGGER [get_debug_ports u_ila_0/probe36]
set_property port_width 1 [get_debug_ports u_ila_0/probe36]
connect_debug_port u_ila_0/probe36 [get_nets [list rd_burst_data_valid]]
create_debug_port u_ila_0 probe
set_property PROBE_TYPE DATA_AND_TRIGGER [get_debug_ports u_ila_0/probe37]
set_property port_width 1 [get_debug_ports u_ila_0/probe37]
connect_debug_port u_ila_0/probe37 [get_nets [list mem_test_m0/rd_burst_data_valid]]
create_debug_port u_ila_0 probe
set_property PROBE_TYPE DATA_AND_TRIGGER [get_debug_ports u_ila_0/probe38]
set_property port_width 1 [get_debug_ports u_ila_0/probe38]
connect_debug_port u_ila_0/probe38 [get_nets [list mem_test_m0/rd_burst_finish]]
create_debug_port u_ila_0 probe
set_property PROBE_TYPE DATA_AND_TRIGGER [get_debug_ports u_ila_0/probe39]
set_property port_width 1 [get_debug_ports u_ila_0/probe39]
connect_debug_port u_ila_0/probe39 [get_nets [list rd_burst_finish]]
create_debug_port u_ila_0 probe
set_property PROBE_TYPE DATA_AND_TRIGGER [get_debug_ports u_ila_0/probe40]
set_property port_width 1 [get_debug_ports u_ila_0/probe40]
connect_debug_port u_ila_0/probe40 [get_nets [list mem_test_m0/rd_burst_req]]
create_debug_port u_ila_0 probe
set_property PROBE_TYPE DATA_AND_TRIGGER [get_debug_ports u_ila_0/probe41]
set_property port_width 1 [get_debug_ports u_ila_0/probe41]
connect_debug_port u_ila_0/probe41 [get_nets [list rd_burst_req]]
create_debug_port u_ila_0 probe
set_property PROBE_TYPE DATA_AND_TRIGGER [get_debug_ports u_ila_0/probe42]
set_property port_width 1 [get_debug_ports u_ila_0/probe42]
connect_debug_port u_ila_0/probe42 [get_nets [list mem_test_m0/wr_burst_data_req]]
create_debug_port u_ila_0 probe
set_property PROBE_TYPE DATA_AND_TRIGGER [get_debug_ports u_ila_0/probe43]
set_property port_width 1 [get_debug_ports u_ila_0/probe43]
connect_debug_port u_ila_0/probe43 [get_nets [list wr_burst_data_req]]
create_debug_port u_ila_0 probe
set_property PROBE_TYPE DATA_AND_TRIGGER [get_debug_ports u_ila_0/probe44]
set_property port_width 1 [get_debug_ports u_ila_0/probe44]
connect_debug_port u_ila_0/probe44 [get_nets [list wr_burst_finish]]
create_debug_port u_ila_0 probe
set_property PROBE_TYPE DATA_AND_TRIGGER [get_debug_ports u_ila_0/probe45]
set_property port_width 1 [get_debug_ports u_ila_0/probe45]
connect_debug_port u_ila_0/probe45 [get_nets [list mem_test_m0/wr_burst_finish]]
create_debug_port u_ila_0 probe
set_property PROBE_TYPE DATA_AND_TRIGGER [get_debug_ports u_ila_0/probe46]
set_property port_width 1 [get_debug_ports u_ila_0/probe46]
connect_debug_port u_ila_0/probe46 [get_nets [list mem_test_m0/wr_burst_req]]
create_debug_port u_ila_0 probe
set_property PROBE_TYPE DATA_AND_TRIGGER [get_debug_ports u_ila_0/probe47]
set_property port_width 1 [get_debug_ports u_ila_0/probe47]
connect_debug_port u_ila_0/probe47 [get_nets [list wr_burst_req]]
# set_property IOSTANDARD LVCMOS33 [get_ports sys_rst]
# set_property PACKAGE_PIN H9 [get_ports sys_rst]
set_property PACKAGE_PIN AN17 [get_ports {c0_ddr4_adr[0]}]
set_property PACKAGE_PIN AG14 [get_ports {c0_ddr4_odt[0]}]
set_property PACKAGE_PIN AL12 [get_ports {c0_ddr4_dqs_t[3]}]
set_property PACKAGE_PIN AJ10 [get_ports {c0_ddr4_dqs_t[2]}]
set_property PACKAGE_PIN AN5 [get_ports {c0_ddr4_dqs_t[1]}]
set_property PACKAGE_PIN AM8 [get_ports {c0_ddr4_dqs_t[0]}]
set_property PACKAGE_PIN AK13 [get_ports {c0_ddr4_dq[31]}]
set_property PACKAGE_PIN AK11 [get_ports {c0_ddr4_dq[30]}]
set_property PACKAGE_PIN AL13 [get_ports {c0_ddr4_dq[29]}]
set_property PACKAGE_PIN AK9 [get_ports {c0_ddr4_dq[28]}]
set_property PACKAGE_PIN AM11 [get_ports {c0_ddr4_dq[27]}]
set_property PACKAGE_PIN AK10 [get_ports {c0_ddr4_dq[26]}]
set_property PACKAGE_PIN AM12 [get_ports {c0_ddr4_dq[25]}]
set_property PACKAGE_PIN AJ11 [get_ports {c0_ddr4_dq[24]}]
set_property PACKAGE_PIN AE11 [get_ports {c0_ddr4_dq[23]}]
set_property PACKAGE_PIN AF10 [get_ports {c0_ddr4_dq[22]}]
set_property PACKAGE_PIN AF11 [get_ports {c0_ddr4_dq[21]}]
set_property PACKAGE_PIN AG10 [get_ports {c0_ddr4_dq[20]}]
set_property PACKAGE_PIN AH10 [get_ports {c0_ddr4_dq[19]}]
set_property PACKAGE_PIN AG9 [get_ports {c0_ddr4_dq[18]}]
set_property PACKAGE_PIN AF12 [get_ports {c0_ddr4_dq[17]}]
set_property PACKAGE_PIN AH9 [get_ports {c0_ddr4_dq[16]}]
set_property PACKAGE_PIN AP6 [get_ports {c0_ddr4_dq[15]}]
set_property PACKAGE_PIN AP3 [get_ports {c0_ddr4_dq[14]}]
set_property PACKAGE_PIN AM6 [get_ports {c0_ddr4_dq[13]}]
set_property PACKAGE_PIN AN2 [get_ports {c0_ddr4_dq[12]}]
set_property PACKAGE_PIN AM5 [get_ports {c0_ddr4_dq[11]}]
set_property PACKAGE_PIN AP2 [get_ports {c0_ddr4_dq[10]}]
set_property PACKAGE_PIN AP5 [get_ports {c0_ddr4_dq[9]}]
set_property PACKAGE_PIN AN1 [get_ports {c0_ddr4_dq[8]}]
set_property PACKAGE_PIN AP10 [get_ports {c0_ddr4_dq[7]}]
set_property PACKAGE_PIN AN10 [get_ports {c0_ddr4_dq[6]}]
set_property PACKAGE_PIN AN12 [get_ports {c0_ddr4_dq[5]}]
set_property PACKAGE_PIN AN8 [get_ports {c0_ddr4_dq[4]}]
set_property PACKAGE_PIN AP11 [get_ports {c0_ddr4_dq[3]}]
set_property PACKAGE_PIN AM10 [get_ports {c0_ddr4_dq[2]}]
set_property PACKAGE_PIN AN13 [get_ports {c0_ddr4_dq[1]}]
set_property PACKAGE_PIN AN7 [get_ports {c0_ddr4_dq[0]}]
set_property PACKAGE_PIN AL9 [get_ports {c0_ddr4_dm_dbi_n[3]}]
set_property PACKAGE_PIN AG12 [get_ports {c0_ddr4_dm_dbi_n[2]}]
set_property PACKAGE_PIN AP8 [get_ports {c0_ddr4_dm_dbi_n[1]}]
set_property PACKAGE_PIN AP13 [get_ports {c0_ddr4_dm_dbi_n[0]}]
set_property PACKAGE_PIN AJ16 [get_ports {c0_ddr4_cs_n[0]}]
set_property PACKAGE_PIN AJ15 [get_ports {c0_ddr4_cke[0]}]
set_property PACKAGE_PIN AK15 [get_ports {c0_ddr4_bg[0]}]
set_property PACKAGE_PIN AH18 [get_ports {c0_ddr4_ba[1]}]
set_property PACKAGE_PIN AL17 [get_ports {c0_ddr4_ba[0]}]
set_property PACKAGE_PIN AH13 [get_ports c0_ddr4_act_n]
set_property PACKAGE_PIN AF14 [get_ports c0_ddr4_reset_n]
set_property PACKAGE_PIN AH14 [get_ports {c0_ddr4_adr[1]}]
set_property PACKAGE_PIN AP17 [get_ports {c0_ddr4_adr[2]}]
set_property PACKAGE_PIN AE16 [get_ports {c0_ddr4_adr[3]}]
set_property PACKAGE_PIN AM16 [get_ports {c0_ddr4_adr[4]}]
set_property PACKAGE_PIN AJ18 [get_ports {c0_ddr4_adr[5]}]
set_property PACKAGE_PIN AM17 [get_ports {c0_ddr4_adr[6]}]
set_property PACKAGE_PIN AL18 [get_ports {c0_ddr4_adr[7]}]
set_property PACKAGE_PIN AP16 [get_ports {c0_ddr4_adr[8]}]
set_property PACKAGE_PIN AN18 [get_ports {c0_ddr4_adr[9]}]
set_property PACKAGE_PIN AJ13 [get_ports {c0_ddr4_adr[10]}]
set_property PACKAGE_PIN AF13 [get_ports {c0_ddr4_adr[11]}]
set_property PACKAGE_PIN AF16 [get_ports {c0_ddr4_adr[12]}]
set_property PACKAGE_PIN AK18 [get_ports {c0_ddr4_adr[13]}]
set_property PACKAGE_PIN AG15 [get_ports {c0_ddr4_ck_t[0]}]
set_property PACKAGE_PIN AJ17 [get_ports c0_sys_clk_p]
set_property PACKAGE_PIN AK14 [get_ports {c0_ddr4_adr[14]}]
set_property PACKAGE_PIN AH17 [get_ports {c0_ddr4_adr[15]}]
set_property PACKAGE_PIN AG17 [get_ports {c0_ddr4_adr[16]}]
set_property C_CLK_INPUT_FREQ_HZ 300000000 [get_debug_cores dbg_hub]
set_property C_ENABLE_CLK_DIVIDER false [get_debug_cores dbg_hub]
set_property C_USER_SCAN_CHAIN 1 [get_debug_cores dbg_hub]
connect_debug_port dbg_hub/clk [get_nets clk]
