OpenSourceSDRLab/RFSoC-27DR/vivado/GTY_IBERT_25G/ibert_ultrascale_gty_0_ex/imports/ibert_ultrascale_gty_ip_example.xdc

set_property PACKAGE_PIN H33 [get_ports {gty_rxp_i[3]}]
set_property PACKAGE_PIN K33 [get_ports {gty_rxp_i[2]}]
set_property PACKAGE_PIN M33 [get_ports {gty_rxp_i[1]}]
set_property PACKAGE_PIN P33 [get_ports {gty_rxp_i[0]}]
